KarpelesLab/scaffold/hw/rev2/DESIGN.md

# Scaffold Rev 2 — design specification

Status: **draft, in progress**. Nothing here has been built or tested yet.

Rev 2 keeps the Rev 1.1 board's function, form factor (195 x 150 mm), connectors
and register map, and changes three things:

1. Micro-USB is replaced by a USB-C receptacle.
2. The power tree is redesigned around USB Power Delivery (12 V request) with a
   wide-range external input, so the DUT and platform supplies can reach 5 V at
   1.5 A each.
3. The Intel Cyclone IV EP4CE22 (TQFP-144) is replaced by an AMD/Xilinx
   Artix-7 in the CSG324 package (XC7A35T, or XC7A100T on the same footprint).

The design moves from Altium to KiCad (`hw/kicad/`). The Altium files and the
Rev 1.1 fabrication outputs are kept unchanged for reference.

All part numbers are LCSC/JLCPCB codes, checked against JLCPCB's parts API on
2026-11-08. Stock changes daily: re-check before ordering (`hw/rev2/jlc_check.py`).

## 1. USB-C and power input

```
USB-C (J200) --VBUS--+-- CH224A (PD sink, requests 12 V) --> PG, I2C to FPGA
                     |
                     +--> TPS2121 IN2 ---+
CN202 terminal block (7-20 V) --> IN1 ---+--> VIN (5..20 V) --> S200 power switch
```

| Ref | Function | Part | LCSC | Notes |
|---|---|---|---|---|
| J200 | USB-C receptacle | GCT USB4105-GF-A | C3020560 | USB 2.0, 5 A, THT shell pegs for mechanical strength |
| U209 | USB-PD sink controller | WCH CH224A | C42459160 | ESSOP-10. 24 kΩ on CFG1 = 12 V request. Single-resistor mode also enables I²C (addr 0x22/0x23) |
| U210 | Input power mux | TI TPS2121RUXR | C485916 | 2.8–22 V, 4.5 A, priority to the external input |

Rules:

- **CH224A DP/DM pins are left unconnected.** They perform BC1.2/QC
  handshakes, which would corrupt the FT232RL USB data on D+/D-. PD is
  negotiated on CC only.
- VBUS and VHV are tied together (datasheet), 1 µF/50 V on VHV.
- CH224A CFG2/SCL and CFG3/SDA go to FPGA bank 15 (3.3 V) with 4.7 kΩ pull-ups
  to 3V3. The gateware can later read the PD contract (register 0x09 status,
  0x50 maximum current in 50 mA units) and request another voltage (0x0A).
  CH224A PG (open drain, active low) goes to the FPGA and to a "PD OK" LED.
- D+/D- go from J200 (A6/B6, A7/B7 paired) to the FT232RL through the existing
  ESD diodes, 90 Ω differential.
- With a plain 5 V source (no PD), the board still runs but the VPRE buck goes
  into dropout: DUT/platform supplies are then limited to about 4.2 V, as on
  Rev 1.1.

## 2. Power tree

```
VIN (5-20 V)
 |-- U211 TPS62933P  -> VPRE 6.0 V / 3 A ---+-- U200 TL1963A -> VCC_PLATFORM 1.2-5.0 V / 1.5 A
 |                                          +-- U202 TL1963A -> VCC_DUT      1.2-5.0 V / 1.5 A
 |                                          +-- U205 TL1963A -> VCC_IO_FPGA  1.2-3.3 V
 |                                          +-- U212 TL1963A -> Vsupply      5.0 V (FT232, level shifters, LED driver)
 |-- U213 TPS62933P  -> 1V0   (VCCINT, VCCBRAM) -- PG -+
 |-- U214 TPS62933P  -> 1V8   (VCCAUX, VCCADC)  <- EN -+ -- PG -+
 |-- U215 TPS62933P  -> 3V3_FPGA (VCCO 0/14/15, flash, osc) <- EN +
```

| Ref | Function | Part | LCSC |
|---|---|---|---|
| U211, U213–U215 | 3 A synchronous buck, 3.8–30 V in, with PG | TI TPS62933PDRLR | C5219254 |
| U200, U202, U205, U212 | 1.5 A low-noise adjustable LDO | TI TL1963ADCQR (unchanged from Rev 1.1) | C86720 |

- The DUT and platform supplies stay on low-noise LDOs. Switching regulators
  are never in the measured path, which matters for side-channel measurements
  through the shunt amplifier.
- VPRE = 6.0 V leaves 0.66 V headroom over the TL1963A 340 mV dropout at 1.5 A
  for a 5.0 V output. Worst-case LDO dissipation (1.2 V out, 1.5 A) is 7.2 W:
  more than an SOT-223 can sink. The PTC fuses (F202, F203) on the external
  platform/DUT supply inputs stay at 0.5 A as on Rev 1.1.
  **Open point:** add a thermal pad array or limit to 1 A at low output
  voltages; to be decided at layout.
- Artix-7 sequencing per DS181: VCCINT → VCCAUX → VCCO. The 1V0 buck starts
  first; its PG (pulled up to Vsupply 5 V, within the 5.5 V EN/PG limit)
  enables 1V8, whose PG enables 3V3_FPGA. VCC_IO_FPGA's TL1963A enable is
  driven by the 3V3 PG.
- TPS62933P switching frequency: 500 kHz (RT floating) on VPRE, 1.2 MHz on the
  FPGA rails (smaller inductors). Inductors and capacitors from the JLC basic
  library where possible; values set at schematic capture from the datasheet
  design equations.
- Power budget at 12 V / 3 A (36 W): DUT 7.5 W + platform 7.5 W + VCC_IO 2 W +
  FPGA (35T, worst case) ~2 W + logic 1 W ≈ 20 W input with conversion losses.

### As captured (hw/kicad/Power.kicad_sch, generated by hw/rev2/tools/gen_power.py)

| Rail | Regulator | Divider (top/bottom) | Nominal | Inductor (LCSC) |
|---|---|---|---|---|
| VPRE | U211 TPS62933P, 500 kHz | 30k / 4.7k | 5.91 V | 10 µH CJiang FXL1040-100-M (C475915), 7.8 A |
| 1V0 | U213 TPS62933P | 2.4k / 10k | 0.99 V | 3.3 µH FNR6045S3R3NT (C168063) |
| 1V8 | U214 TPS62933P | 15k / 12k | 1.80 V | 4.7 µH FNR6045S4R7MT (C168067) |
| 3V3_FPGA | U215 TPS62933P | 47k / 15k | 3.31 V | 10 µH FNR6045S100MT (C168076) |
| Vsupply | U212 TL1963A (from VPRE) | 47k / 15k | 5.00 V | — |

- Only JLC basic resistors and capacitors are used in the new power section.
- TPS2121: PR1 51k/10k (VEXT priority above 6.5 V), OV1/OV2 200k/10k (cut-off
  above 22 V on either input), ILM 22k (about 4.5 A), SS 10 nF, ST tied to GND.
- SMAJ20A TVS on VBUS_C (D207) and VEXT (D210).
- USB-PD status: D208 (red, basic part) lights when the CH224A reports the 12 V
  contract (PG low). PD_SCL/PD_SDA are global labels to the FPGA sheet, with
  10k pull-ups to 3V3_FPGA.
- **FT232RL USB detection**: Rev 1.1 divided VBus directly into RESET#
  (4.75k/10k), which would put 8 V on RESET# at 12 V. Rev 2 adds R222 4.7k +
  D209 4.7 V zener (VBUS_SENSE), and R603 becomes 1k: RESET# is about 3.2 V
  with 5 V VBUS and stays below 4.4 V at 20 V.
- Removed from Rev 1.1: J200 micro-B, F200/F201, L200, CN203 (source select
  jumper, replaced by the TPS2121), D202 (6 V ESD diode on VBus, replaced by
  the TVS), U204/U206/U207/U208 and their capacitors (old FPGA/LED rails).
- The new footprint for the FXL1040 inductor is in `hw/kicad/Scaffold_Rev2.pretty`
  (land pattern from the CJiang datasheet).
- **To check against the TI drawing before ordering**: the KiCad
  `Texas_VQFN-HR-12_2x2.5mm` footprint used for the TPS2121 (RUX0012A).

## 3. FPGA

| Ref | Function | Part | LCSC |
|---|---|---|---|
| U100 | FPGA | XC7A35T-1CSG324I (default) / XC7A100T-1CSG324C (same footprint) | C1521726 / C1521768 |
| U105 | Configuration flash, 128 Mbit quad SPI | Winbond W25Q128JVSIQ (JLC basic part) | C97521 |
| P100 | JTAG | 2x7 2.0 mm Xilinx header, or 6-pin 2.54 mm (Digilent HS2 pinout) | — |
| Y100 | 25 MHz oscillator | unchanged | — |

- Configuration mode: Master SPI x4 (M[2:0] = 001), CFGBVS = VCCO (bank 0 at 3.3 V).
- The 25 MHz oscillator goes to an MRCC pin in bank 14 or 15. The MMCM
  generates the 100 MHz system clock (VCO 1000 MHz).
- Banks 14 and 15 are on 3V3_FPGA (UART, LED driver, PD controller, flash,
  power enables). Banks 34 and 35 (HR banks) are on the adjustable
  VCC_IO_FPGA and carry the DUT/platform I/Os (A0–A3, D0–D15, P0–P15).
- The design needs about 60 pins out of 210, so only the two outer ball rows
  need breaking out. Unused balls stay unconnected.
- Programming: JTAG through Vivado, or `openFPGALoader`, which also programs
  the W25Q128 flash. The Vivado flash programmer does not list every
  Winbond part, so check before relying on it.

Gateware: `fpga-arch/artix7/` (Vivado build script `build.tcl`, constraints
`scaffold.xdc`). The vendor-specific Rev 1.x modules are replaced by
vendor-neutral ones; the Rev 1.x Quartus project is unchanged.

### As captured (hw/kicad/FPGA.kicad_sch, generated by hw/rev2/tools/gen_fpga.py)

- Pin assignment: `hw/rev2/fpga_pins.csv` (71 nets). Generated automatically:
  outermost balls first in each bank, clocks on MRCC pins, configuration
  pins of bank 14 reserved. Banks 35 (IO0-15_DUT, D0-D2 pulls) and 34
  (IO0-15_PLAT) on VCC_IO_FPGA; bank 15 (clocks, reset, LED driver, A0-A3,
  DIR, TEARING, power enables) and bank 14 (UART, PD I2C, 7 spare I/Os to
  TP102-TP108) on 3V3_FPGA. `fpga-arch/artix7/scaffold.xdc` pins are generated
  from it by `hw/rev2/tools/gen_xdc.py`.
- Configuration: W25Q128JVSIQ (U105) on CCLK/D00-D03/FCS_B; 10k pull-ups on
  FCS_B, IO2 (/WP), IO3 (/HOLD); PROGRAM_B and INIT_B 4.7k pull-ups; DONE
  330 Ω pull-up; M0 1k to 3V3, M1/M2 1k to GND; PUDC_B 1k to 3V3 (I/O
  pull-ups off during configuration; LED_/OE, the power enables and the
  level shifter DIR lines all have external pulls). CFGBVS to 3V3.
- JTAG: 1x6 0.1" header P100 with the Digilent JTAG-HS2/HS3 pinout
  (1 VDD, 2 GND, 3 TCK, 4 TDO, 5 TDI, 6 TMS); also usable with
  openFPGALoader and FT2232H-based cables.
- Unused special pins: VP/VN, VREFP/VREFN (internal XADC reference),
  DXP/DXN, VCCBATT tied to GND. VCCADC from 1V8 through a ferrite bead
  (L100), 1 µF + 100 nF.
- Decoupling per UG483 v1.13 Table 2-2, sized for the XC7A100T so both
  devices can be fitted: 1V0 2x100 µF + 6x4.7 µF + 10x0.47 µF, 1V8
  47 µF + 2x4.7 µF + 4x0.47 µF, 3V3 banks 2x47 µF + 5x4.7 µF + 10x0.47 µF,
  VCC_IO banks 47 µF + 4x4.7 µF + 8x0.47 µF (all JLC basic parts). The
  330 µF VCCINT bulk of the XC7A100T is replaced by ceramics.

## 4. Other changes forced by availability

- **LED driver** (decided, captured in `hw/kicad/LEDs.kicad_sch`, generated by
  `hw/rev2/tools/gen_leds.py`): the TLC5952DAP is out of stock at JLCPCB.
  It is replaced by 3 x 74HC595D (Nexperia 74HC595D,118, LCSC C5947, JLC basic
  part) U400–U402 on 3V3_FPGA. LED anodes move from Vsupply (5 V) to
  3V3_FPGA and each cathode goes through a resistor to a 74HC595 output
  (active low): 680 Ω (~1.8 mA) for the single LEDs, 330 Ω for the bicolour
  D400/D401. The Rev 1.1 channel of every LED is kept (bit k drives the LED
  that was on TLC5952 output k). U400 QA..QH = LED0..7, U401 = LED8..15,
  U402 = LED16..23; QH' of U402 returns to the FPGA as LED_SDO. R425 (10k
  pull-up on LED_/OE) keeps the LEDs off until the FPGA is configured.
  Gateware: `fpga-arch/artix7/tlc5952_driver.vhd` keeps the entity name and
  ports (so `leds_module` is unchanged), shifts the inverted LED bits, and
  turns the brightness into a ~10 kHz PWM on /OE with duty
  (brightness + 1)/128. Tested in `fpga-sim/artix7/tb_leds.vhd`.
- **EPCS16** (Intel-only configuration device) → W25Q128JVSIQ, see above.
- **ADA4895-1ARJZ** (current measurement amplifier) is in low stock (33 pcs,
  ~$10). Keep, re-check before ordering.

## 5. PCB

- Stackup (decided): **6 layers**, JLC 1.6 mm.
  Layers: L1 signal, L2 GND, L3 signal, L4 power, L5 GND, L6 signal.
  The under-BGA decoupling capacitors sit on their vias (via-in-pad): order
  with JLC's epoxy-filled, capped vias (POFV) option. The
  CSG324 is a 0.8 mm-pitch BGA; 6 layers keep two solid ground planes,
  including the one under the analog measurement path.
- BGA fanout: 0.2 mm drill / 0.4 mm via, 0.1 mm tracks under the BGA
  (JLC multilayer minimum: 0.09 mm track/space, 0.15 mm drill).
- Board outline, mounting holes, connector, LED and SMA positions unchanged.

### Layout as implemented (scripted, see `hw/rev2/tools/layout.sh`)

Pipeline: `layout_rules.py` (rules, net classes) -> `update_pcb.py` (sync
with the schematic) -> `place.py` (placement, bucks from the `buck.py`
template) -> `fanout.py` (BGA fanout, decoupling, planes) -> `stitch.py`
(plane vias, buck power copper) -> `manual_routes.py` (J501-J502 bus) ->
routing. `layout.sh` runs these steps; routing was then done as follows,
and the board file is the reference (the routing steps are not a one-shot
script):

1. Freerouting, incremental (`route.py export` locks existing copper and
   prunes dangling stubs; `route.py import`; `postroute.py` fixes minimum
   widths and slivers). Five passes took the board from ~500 to 43
   unconnected; each pass is ~1.5 h and gains less.
2. `maze.py`, a grid A* router written for the rest (numpy/scipy, runs
   outside KiCad): `maze_export.py` -> `maze.py` -> `maze_apply.py`.
   0.05 mm grid aligned on the BGA pitch, top/Signal/bottom layers, net
   class clearances checked with a grid margin (`MAZE_TIGHT` for fine-pitch
   escapes, every result verified with KiCad's DRC), connectivity through
   planes, per-net width/via/neck overrides and flags (outer layers only,
   extra vias, no vias). `ripup.py` clears a box or whole nets when a pad
   is boxed in; boxed-in areas were re-routed with the stuck net first.
3. The 3 A input stage (VBUS_C, VEXT, VIN_MUX: 0.8 mm on the outer 1 oz
   layers, extra vias at each layer change, 0.35 mm necks at the TPS2121
   pins) and the DUT/platform supplies (VCC_DUT, VCC_PLATFORM and the
   PERMANENT nets: 1.5 mm, outer layers) were ripped up and re-routed wide.

4. Post-route copper (review of 2026-11-09, section 8): `thermal.py`
   (vias in the LDO ground tabs and in the SMA ground legs, group
   `rev2_thermal`) and `widen.py` (power tracks widened where they clear,
   extra vias and parallel links, group `rev2_power`).

Result: 0 unconnected pads, no clearance, short or track-width errors.

- Stackup: Top (signal) / GND1 (plane) / Signal / Power (split plane) /
  GND2 (plane) / Bottom (signal). The board file carries JLC's
  JLC06161H-2116 build (1.6 mm): 35 um outer / 15.2 um inner copper;
  dielectrics 0.2234 mm (2116+2313, er 4.1), 0.3 mm core (4.6), 0.4168 mm
  (2 x 7628, 4.4), 0.3 mm core, 0.2234 mm. Select this stackup when
  ordering if impedance matters (see section 8).
- Rules: 0.1 mm track/clearance for the BGA nets (classes FPGA_IO,
  FPGA_PWR, GND), 0.2 mm default, 0.8 mm power tracks; vias 0.4/0.2 mm at the
  BGA, 0.6/0.3 mm elsewhere. kicad-cli ignores `.kicad_dru` custom rules,
  so every constraint is expressed through net classes.
- Placement: everything kept from Rev 1.1 is untouched (connectors,
  headers J500-J503 for daughter board compatibility, SMA, LEDs, DIP
  switches, holes). USB-C at the old micro-USB position; PD controller and
  input mux below it; VPRE/1V8/3V3 bucks in the former logo area; the 1V0
  buck next to the BGA (short high-current path). Each TPS62933P follows one
  template: input caps on VIN/GND (pins 3/4), bootstrap cap on BST/SW (pins
  6/5), inductor next to SW, output caps against the inductor, FB divider
  above the IC; input loop, bootstrap and output tracks are drawn by script
  and the switch node is a small top-layer zone (pin 5, Cbst, inductor). BGA rotated 180 degrees so
  banks 34/35 (DUT/platform I/Os) face the J500-J503 headers.
- Fanout: dog-bone vias for every power/ground ball and every signal ball
  from the third ring inwards; the two outer rings escape on the top layer.
- Decoupling: 0402 capacitors on supply/ground via pairs under the BGA, the
  others in a ring around it on the side of their plane region; bulk
  capacitors beyond the ring.
- Power plane (In3): 1V0 island under the core with a corridor through
  unused ball rows to its buck; 1V8 strip from the VCCAUX column; 3V3 (left,
  bottom, LED rows) and VCC_IO (banks 34/35 side) split under the BGA by
  nearest VCCO ball; VIN in the power input area; VPRE from its buck to the
  LDO inputs. The buck inputs get 12 V from a VIN zone on the Signal layer
  (In2), which has nothing else to carry in the power area.
- Known DRC items accepted (95 errors, all footprints): Rev 1.1 edge-mount
  SMA connectors CN100/CN2xx/CN3xx (copper at the board edge by design,
  internal hole and mask clearances), GCT USB4105 land pattern J200
  (0.194 mm hole clearance vs 0.2 mm rule); warnings: terminal block
  padstacks, silkscreen sizes and library mismatches of the footprints
  imported from Altium, U100 no-connect net names (unit suffix) and empty
  Description fields in the schematic parity check.
- Placement changes made while routing: C224 (mux output cap) above-right
  of U210, so the 3 A output does not cross the inputs; LED resistors
  R409-R424 in two rows at 4 mm pitch (2 mm left no room to route).

## 6. JLCPCB outputs

Generated by `hw/rev2/make_jlc.py` (KiCad Python) into `hw/rev2/jlc/`:

- `scaffold-rev2-gerbers.zip`: 6 copper layers, mask, paste, silkscreen,
  outline and Excellon drill files (absolute origin for both)
- `bom-jlc.csv`: Comment, Designator, Footprint, LCSC
- `cpl-jlc.csv`: Designator, Mid X, Mid Y, Layer, Rotation (pad centres)
- `hand-assembly.csv`: parts JLCPCB does not stock (Samtec SMA, headers,
  terminal blocks, switches, Mill-Max pins), to fit by hand
- `drc.txt`, `report.txt`

LCSC numbers come from the footprint `LCSC` field or, for parts carried over
from Rev 1.1, from `hw/rev2/lcsc_map.csv` by manufacturer part number
(`assembly` column: `jlc` or `hand`). Check rotations in JLCPCB's placement
preview: footprints imported from Altium may need a correction.

## 7. Pre-order review checklist

Points that need a human check (datasheet or tool not available here):

1. TPS2121 footprint (KiCad `Texas_VQFN-HR-12_2x2.5mm_P0.5mm`) against TI's
   RUX0012A land pattern.
2. Digilent 6-pin JTAG pinout (taken from the JTAG-HS2 reference manual figure).
3. Tie-off of DXP/DXN and VCCBATT to GND (secondary sources agree; UG480 /
   UG470 not checked directly).
4. VCCINT bulk: ceramic 2 x 100 µF instead of the 330 µF in UG483 for the
   XC7A100T. Check stability with the TPS62933 (ceramic-compensated) if the
   XC7A100T is fitted.
5. Platform/DUT LDO dissipation at low output voltage and high current (see
   section 2).
6. W25Q128JV quad mode: the QE bit must be set when programming the flash
   (openFPGALoader does it); Vivado's flash programmer may not support this
   part.
7. Vivado synthesis and timing of `fpga-arch/artix7` (no Vivado on the machine
   used for the port: only simulated/elaborated with nvc).
8. Layout review by a person before ordering: the board was placed and
   routed by scripts. In particular the buck switching loops (template in
   `buck.py`), the TPS2121 area (0.35 mm necks into its 0.5 mm-pitch pins),
   the analog path (ADA4895 area, kept from Rev 1.1 placement) and the
   routing near the BGA. The routes are electrically complete and pass DRC;
   they are not as tidy as hand routing (grid steps, some long detours).
9. Order options: 6 layers, 1 oz outer / 0.5 oz inner, via-in-pad plated
   over (POFV) for the 0402 decoupling capacitors under the BGA, minimum
   via 0.4/0.2 mm, minimum track/space 0.1 mm. Inner layer order in the
   Gerbers: GND1 (.g1), Signal (.g2), Power (.g3), GND2 (.g4).
10. Outer ground pours: areas enclosed by tracks without a ground via are
    removed as islands (between the header rows); the two inner ground
    planes are solid. Optional: add ground vias there to keep the pour.
11. Low JLCPCB stock at the time of generation (2026-11-09): ADA4895-1 (33),
    25 MHz oscillator ECS-2520S33-250 (49), XC7A35T (227). Re-check with
    `hw/rev2/jlc_check.py --bom hw/rev2/jlc/bom-jlc.csv --qty N`.
12. VEXT (external input) passes through one 0.4 mm via at (79.0, 53.5)
    next to R225: fine at 12 V (about 2 A), marginal at the 4 A worst
    case (7 V input, full load). No room for a second via on the top
    layer there without moving R223/R225.

## 8. Layout review and simulation (2026-11-09)

Tools in `hw/rev2/sim/` (`run.sh` runs everything; results in
`hw/rev2/sim/results/`):

- `export_copper.py` (KiCad Python): copper of chosen nets, or of every net
  in a box, as polygons per layer with vias, holes and pads.
- `irdrop.py`: DC drop and current density of each power net (resistor
  network on a 0.05/0.1 mm raster, via barrels, worst-case load currents).
- `em_sim.py`: openEMS FDTD model of a box of the real copper (stackup
  above, PEC copper, vias as cylinders, lumped ports, PML). openEMS is
  built from source (`openEMS-Project`, `update_openEMS.sh --python`, needs
  `brew install hdf5 cgal boost`) into `~/opt/openEMS`; its Metal GPU
  engine runs these models about 50x faster than the CPU engine.
  Modelling rules learned the hard way: the copper must run into the PML
  (a track ending at the absorber is an open stub) and vias must stay out
  of it (vertical conductors in the PML make the run unstable).

Findings and changes:

| Check | Result | Action |
|---|---|---|
| DC drop, all power nets, worst case | Largest: VEXT 4 A 123 mV (was 151), VIN_MUX 55 mV, VCC_DUT 57 mV and VCC_PLATFORM 47 mV at 1.5 A, 1V0 24 mV at 2 A, 1V8 24 mV, VCC_IO 7 mV, 3V3 2 mV | VEXT/VIN_MUX/VBUS widened to 1-2 mm where they clear, parallel VEXT links beside the TPS2121 (`widen.py`) |
| Current density | Hot spots only at the TPS2121 pin necks (package-limited) and pad entries; VBUS trunk 0.8 mm beside the mounting hole (3 A, ~20 C rise per IPC-2152) | Noted |
| Return paths | No signal segment runs more than 1.5 mm without its reference plane below (crossings are via antipads under the BGA) | None |
| SMA connectors (13) | Ground legs had no via: the shield current reached the planes only through the top pour | 7 vias in each ground leg (`thermal.py`). CN205 shunt output: S21 at 1 GHz -1.01 -> -0.82 dB, at 2 GHz -3.69 -> -3.37 dB; the rest is the THP200 test-pin hole in the path (as Rev 1.1) |
| LDO tabs (TL1963A) | No via under the ground tab | 0.3 mm via grid in the tabs of U200 (4), U202 (6), U205 (6); U212 has In2 tracks under it (0.2 W, not needed) |
| CLK_EXT (CN100 -> G16) | 0.1 mm top trace, Z0 about 61-75 ohm (port at the SMA pin, line into the absorber); clean via transition into the BGA (port mid-line sees ~33 ohm = Z0/2, flat to 2 GHz) | None: 42 mm at clock edges of ~1 ns, reflection coefficient ~0.15 against a 50 ohm source |
| Buck input loop (U211, VIN -> C226 -> GND) | 1.0 nH including the port gap (0.94-1.03 nH, 100-500 MHz) | None (good for this package; C226 is 1.5 mm from the pins) |
| Stackup in the board file | Was the 4-layer Altium one (no In3/In4, 1.45 mm) | Replaced with JLC06161H-2116 |
| FPGA decoupling | 0.47 uF 1V0 caps 0.4-0.9 mm from their balls (under the BGA); 1V8 caps 7.6-9 mm and 1V0 4.7 uF 6.6-8.4 mm away, fed by the In3 islands | Acceptable at plane level; no PDN impedance simulation was run |
