KarpelesLab/scaffold/hw/rev2/jlc/bom-jlc.csv

Comment | Designator | Footprint | LCSC
100uF 6.3V | C100,C101 | C_1206_3216Metric | C15008
4.7uF 10V | C102,C103,C104,C105,C106,C107,C119,C120,C127,C128,C129,C130,C131,C158,C159,C160,C161 | C_0402_1005Metric | C23733
470nF 10V | C108,C109,C110,C111,C112,C113,C114,C115,C116,C117,C121,C122,C123,C124,C132,C133,C134,C135,C143,C144,C145,C146,C155,C156,C162,C163,C164,C165,C166,C167,C168,C169 | C_0402_1005Metric | C47339
47uF 6.3V | C118,C125,C126,C157 | C_0805_2012Metric | C16780
100nF | C136,C151,C153,C154,C205,C600,C601,C602,C603,C605,C606,C607,C608,C609,C610,C611 | CAP0603 | C14663
10uF | C137,C200,C201,C202,C204,C208,C209,C210,C217,C218 | CAP0603 | C86277
1uF 50V | C170,C221,C222 | C_0603_1608Metric | C15849
100nF 50V | C171,C226,C227,C232,C233,C238,C239,C243,C244,C400,C401,C402 | C_0603_1608Metric | C14663
1uF | C206,C207 | CAP0603 | C15849
10nF 50V | C223 | C_0603_1608Metric | C57112
10uF 50V | C224,C225,C231,C237,C242 | C_1206_3216Metric | C13585
22uF 25V | C228,C229,C230,C234,C235,C236,C240,C241,C245,C246 | C_0805_2012Metric | C45783
10uF 25V | C247,C248 | C_0805_2012Metric | C15850
4.7uF | C604 | CAP0603 | C19666
Male | CN207 | MOLEX_90120-0122 | C3336192
BAT60J | D200,D201,D205,D206 | SOD323_A | C133103
ESDAXLC6-1BT2 | D203,D204 | SOD882 | C154523
SMAJ20A | D207,D210 | D_SMA | C115250
PD 12V OK (red) | D208 | LED_0603_1608Metric | C2286
BZT52C4V7 | D209 | D_SOD-123 | C2116
LED RG | D400,D401 | PLCC-4_3528 | C5872444
KT-0603Y | D402,D403,D404,D405,D406,D407,D408,D409,D410,D411,D412,D416,D417,D418,D419,D420,D421,D422,D423 | LED_0603_1608Metric | C2287
KT-0603R | D415 | LED_0603_1608Metric | C2286
PTC - 1A - 0.5A - 6VDC | F202,F203 | FUSE_0805 | C5220829
USB4105-GF-A | J200 | USB_C_Receptacle_GCT_USB4105-xx-A_16P_TopMnt_Horizontal | C3020560
600R@100MHz | L100 | L_0603_1608Metric | C1002
10uH | L201 | L_CJiang_FXL1040 | C475915
3.3uH | L202 | L_Changjiang_FNR6045S | C168063
4.7uH | L203 | L_Changjiang_FNR6045S | C168067
10uH | L204 | L_Changjiang_FNR6045S | C168076
JTAG | P100 | PinHeader_1x06_P2.54mm_Vertical | C492405
STR2P3LLH6 - SOT23 | Q200,Q203 | SOT23 | C3040112
STT6N3LLH6 - SOT23-6 | Q201,Q202,Q204,Q205 | SOT95P280X145-6N | C3021100
47KOhm | R100 | RES0603 | C25819
10k | R101,R102,R103,R220,R221,R224,R226,R228,R233,R425 | R_0603_1608Metric | C25804
4.7k | R104,R105,R222,R231 | R_0603_1608Metric | C23162
330 | R106,R419,R420,R423,R424 | R_0603_1608Metric | C23138
1k | R107,R108,R109,R113 | R_0603_1608Metric | C21190
10KOhm | R110,R111,R112,R301,R305,R307,R309,R313,R317,R319,R321,R323,R327,R331,R333,R335,R338,R339,R341,R343,R347,R348,R349,R351,R600,R601,R602,R604,R605 | RES0603 | C25804
50 kOhms | R200,R207,R216 | POT_3296W | C83686
470Ohm | R201,R209 | RES0603 | C23179
15KOhm | R202,R211 | RES0603 | C22809
2Ohm | R203,R204,R212,R213 | RES0603 | C22977
1K | R205,R214,R215,R304,R306,R308,R312,R316,R318,R320,R322,R326,R330,R332,R334,R340,R342,R346,R350 | RES0603 | C21190
50 Ohm | R206 | RES0603 | C23185
100Ohm | R208 | RES0603 | C22775
100 Ohms | R210 | POT_3296W | C83688
28KOhm | R217 | RES0603 | C22989
24k | R218 | R_0603_1608Metric | C23352
2.2k | R219 | R_0603_1608Metric | C4190
51k | R223 | R_0603_1608Metric | C23196
200k | R225,R227 | R_0603_1608Metric | C25811
22k | R229 | R_0603_1608Metric | C31850
30k | R230 | R_0603_1608Metric | C22984
2.4k | R232 | R_0603_1608Metric | C22940
15k | R234,R237,R239 | R_0603_1608Metric | C22809
12k | R235 | R_0603_1608Metric | C22790
47k | R236,R238 | R_0603_1608Metric | C25819
100k | R240 | R_0603_1608Metric | C25803
0 Ohm | R300,R302,R303,R310,R311,R314,R315,R336,R337,R344,R345 | RES0603 | C21189
680 | R401,R402,R403,R404,R405,R406,R407,R408,R409,R410,R411,R412,R413,R414,R415,R416,R417,R418,R421,R422 | R_0603_1608Metric | C23228
1 KOhm | R603 | RES0603 | C21190
Misc - DIP switch - 8 rows - TE connectivity - 1825057-7 -ADE0804 | S300,S301,S302,S303 | SWDIP16_300X3.51 | C266199
XC7A35T-1CSG324I | U100 | Xilinx_CSG324 | C1521726
W25Q128JVSIQ | U105 | SOIC-8_5.3x5.3mm_P1.27mm | C97521
TL1963A | U200,U202,U205,U212 | SOT223-6 | C86720
LDK130_33 | U201 | SOT95P280X145-5L30 | C2969807
ADA4895-1 | U203 | SOT95P280X145-6N | C654294
CH224A | U209 | SSOP-10-1EP_3.9x4.9mm_P1mm_EP2.1x3.3mm | C42459160
TPS2121RUXR | U210 | Texas_VQFN-HR-12_2x2.5mm_P0.5mm | C485916
TPS62933PDRLR | U211,U213,U214,U215 | SOT-583-8 | C5219254
74HC595D | U400,U401,U402 | SOIC-16_3.9x9.9mm_P1.27mm | C5947
SN74LVC1T45DBVR | U600,U601,U602,U604 | SOT95P280X145-6N | C7843
IC - USB-to-UART 1-CH 256Byte FIFO - 5V - 28-Pin SSOP | U603 | SSOP28DB | C8690
Oscillator - 25MHz - 3.3V - HCMOS - ECS-2520S33-250-FN-TR | Y100 | XTAL_2520 | C2441341
