KarpelesLab/scaffold/hw/kicad/Scaffold.kicad_pcb

## KiCad design hw/kicad/Scaffold.kicad_pcb (2026-11-09)

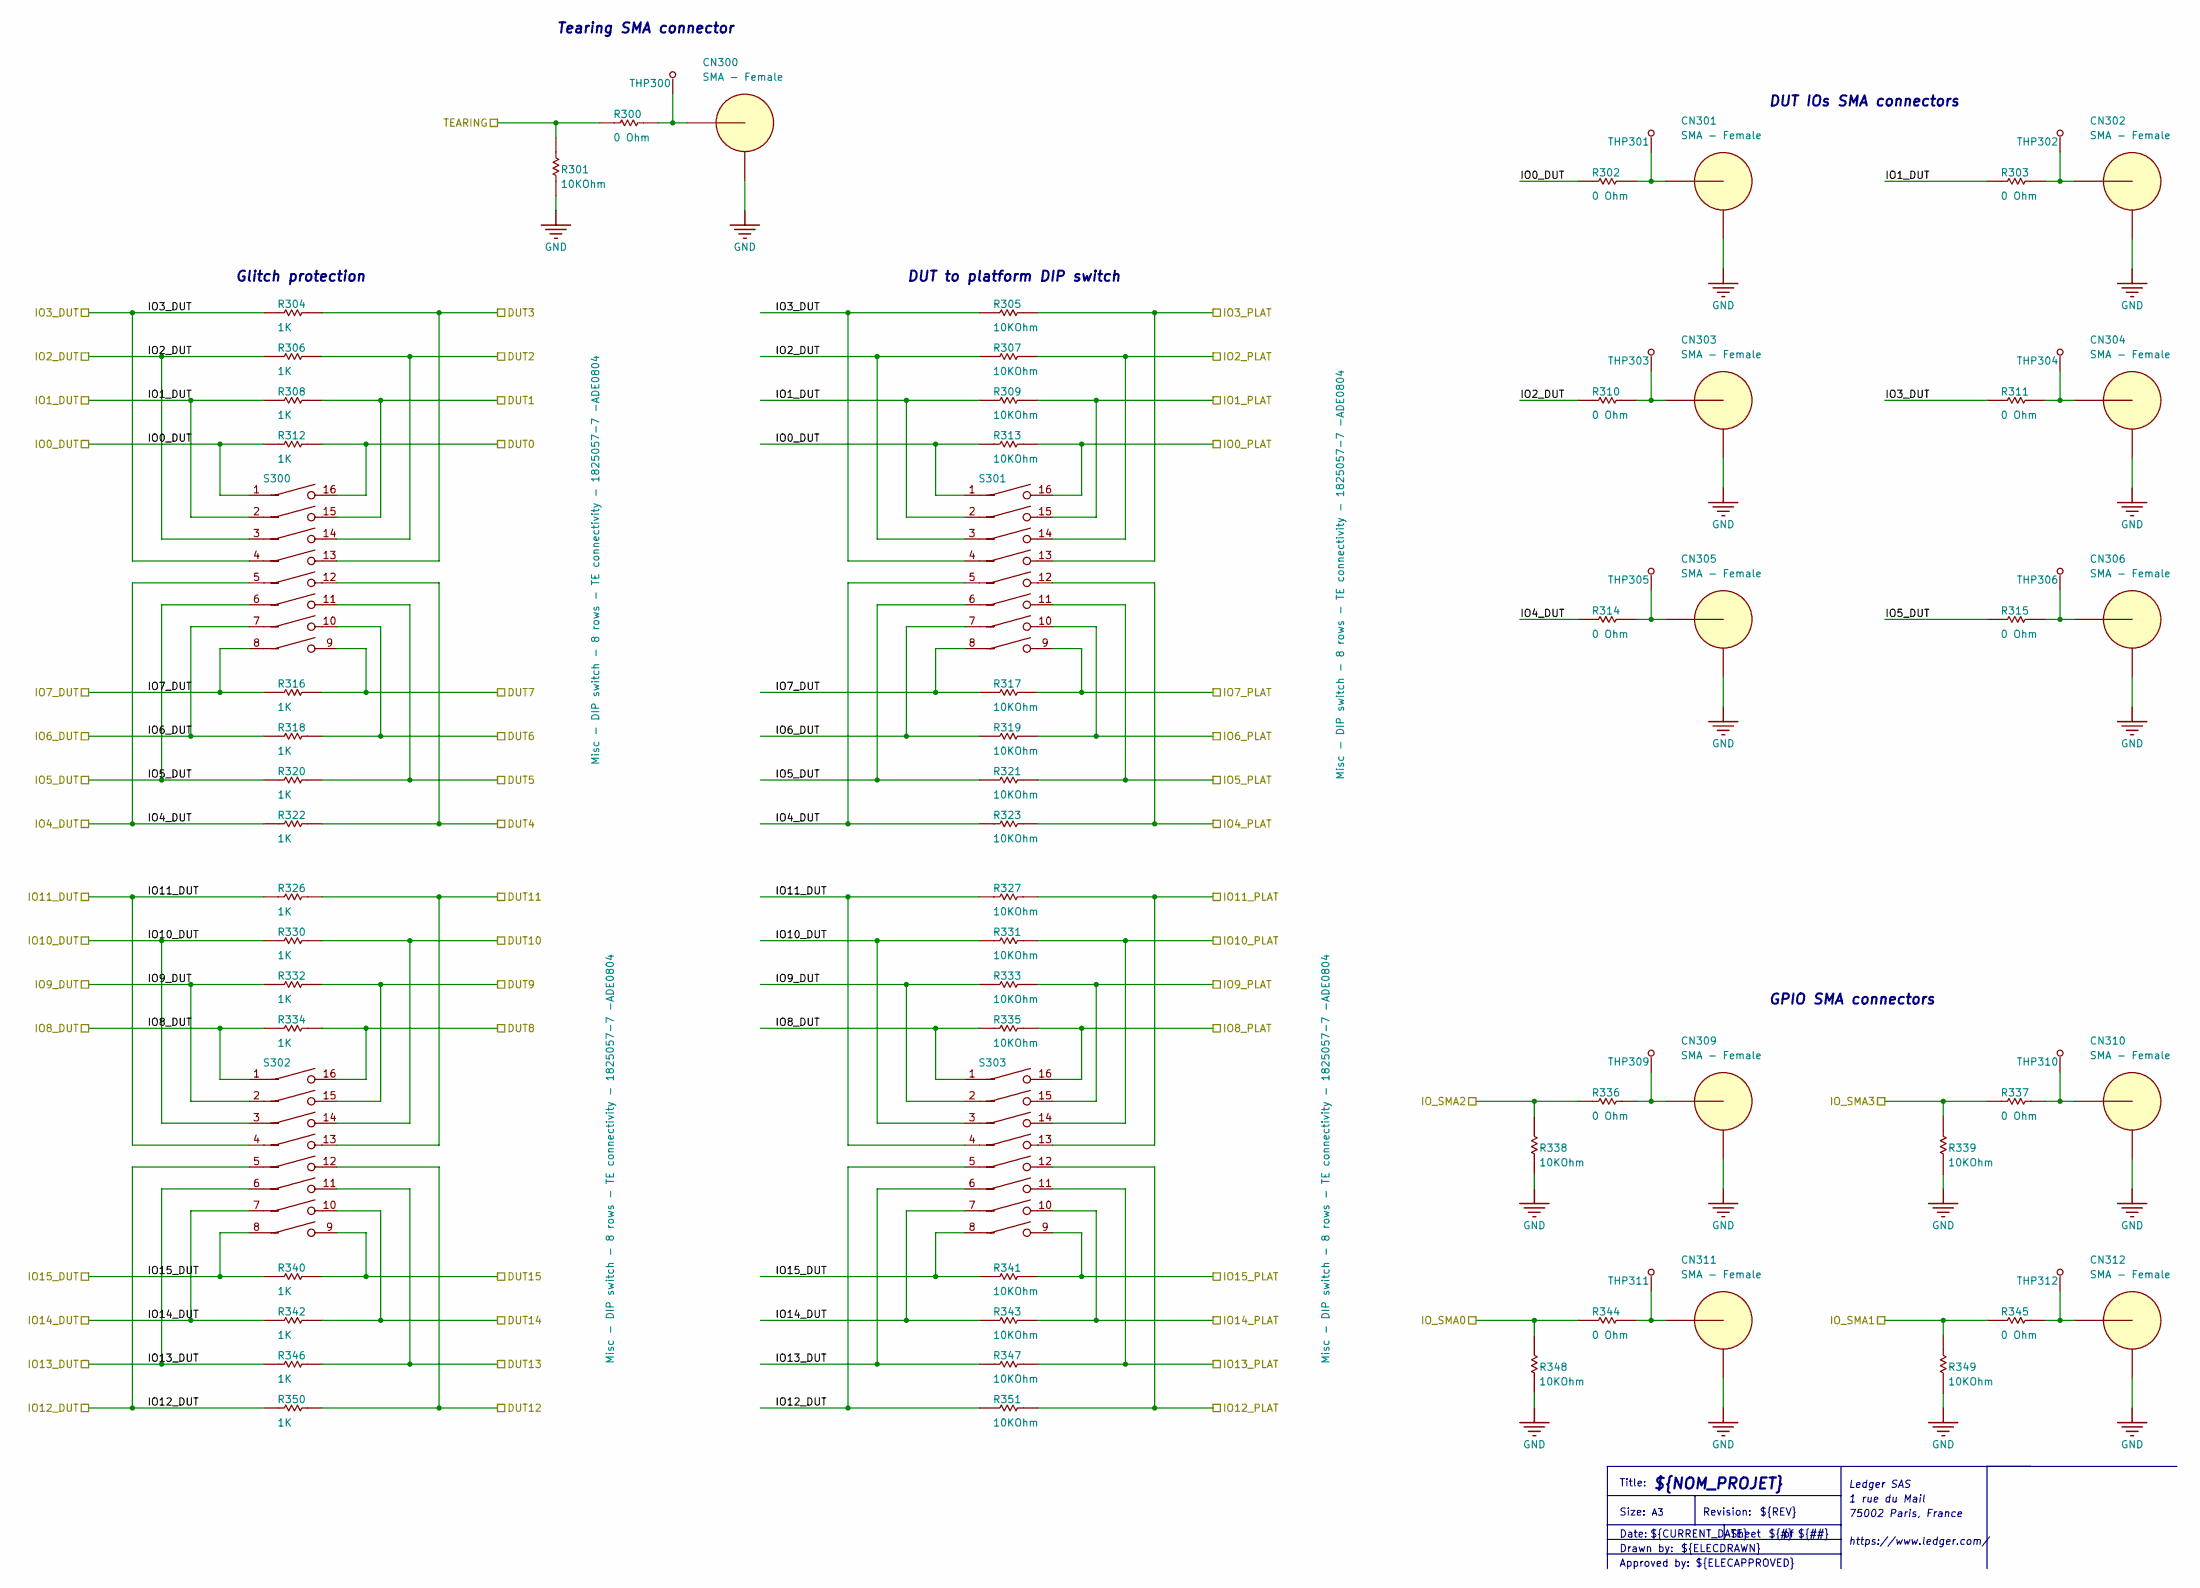
[picture p1: schematic Connectors.kicad_sch]

Parts:
CN300, CN301, CN302, CN303, CN304, CN305, CN306, CN309, CN310, CN311, CN312: SMA - Female; SAMTEC_SMA-J-P-X-ST-EM3; MANUFACTURER PN SMA–J–P–H–ST–EM3
R300, R302, R303, R310, R311, R314, R315, R336, R337, R344, R345: 0 Ohm; RES0603; TOLERANCE 1%; MANUFACTURER PN CRCW06030000FKEA
R301, R305, R307, R309, R313, R317, R319, R321, R323, R327, R331, R333, R335, R338, R339, R341, R343, R347, R348, R349, R351: 10KOhm; RES0603; TOLERANCE 1%; MANUFACTURER PN RC0603FR-0710KL
R304, R306, R308, R312, R316, R318, R320, R322, R326, R330, R332, R334, R340, R342, R346, R350: 1K; RES0603; TOLERANCE 1%; MANUFACTURER PN RC0603FR-071KL
S300, S301, S302, S303: Misc - DIP switch - 8 rows - TE connectivity - 18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; SWDIP16_300X3.51; MANUFACTURER PN1 ADE0804
THP300, THP301, THP302, THP303, THP304, THP305, THP306, THP309, THP310, THP311, THP312: Misc - Test pin - Through hole - Millmax - 6821-0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; MILLMAX_6821-0-00-15-00-00-08-0; MANUFACTURER PN 6821-0-00-15-00-00-08-0

Connections:
/DUT_D0: R312.2, S300.16; also elsewhere on the board
/DUT_D1: R308.2, S300.15; also elsewhere on the board
/DUT_D2: R306.2, S300.14; also elsewhere on the board
/U_Connectors/DUT3: R304.2, S300.13; also elsewhere on the board
/U_Connectors/DUT4: R322.2, S300.12; also elsewhere on the board
/U_Connectors/DUT5: R320.2, S300.11; also elsewhere on the board
/U_Connectors/DUT6: R318.2, S300.10; also elsewhere on the board
/U_Connectors/DUT7: R316.2, S300.9; also elsewhere on the board
/U_Connectors/DUT8: R334.2, S302.16; also elsewhere on the board
/U_Connectors/DUT9: R332.2, S302.15; also elsewhere on the board
/U_Connectors/DUT10: R330.2, S302.14; also elsewhere on the board
/U_Connectors/DUT11: R326.2, S302.13; also elsewhere on the board
/U_Connectors/DUT12: R350.2, S302.12; also elsewhere on the board
/U_Connectors/DUT13: R346.2, S302.11; also elsewhere on the board
/U_Connectors/DUT14: R342.2, S302.10; also elsewhere on the board
/U_Connectors/DUT15: R340.2, S302.9; also elsewhere on the board
/U_Connectors/IO0_DUT: R302.1, R312.1, R313.1, S300.1, S301.1; also elsewhere on the board
/U_Connectors/IO0_PLAT: R313.2, S301.16; also elsewhere on the board
/U_Connectors/IO1_DUT: R303.1, R308.1, R309.1, S300.2, S301.2; also elsewhere on the board
/U_Connectors/IO1_PLAT: R309.2, S301.15; also elsewhere on the board
/U_Connectors/IO2_DUT: R306.1, R307.1, R310.1, S300.3, S301.3; also elsewhere on the board
/U_Connectors/IO2_PLAT: R307.2, S301.14; also elsewhere on the board
/U_Connectors/IO3_DUT: R304.1, R305.1, R311.1, S300.4, S301.4; also elsewhere on the board
/U_Connectors/IO3_PLAT: R305.2, S301.13; also elsewhere on the board
/U_Connectors/IO4_DUT: R314.1, R322.1, R323.1, S300.5, S301.5; also elsewhere on the board
/U_Connectors/IO4_PLAT: R323.2, S301.12; also elsewhere on the board
/U_Connectors/IO5_DUT: R315.1, R320.1, R321.1, S300.6, S301.6; also elsewhere on the board
/U_Connectors/IO5_PLAT: R321.2, S301.11; also elsewhere on the board
/U_Connectors/IO6_DUT: R318.1, R319.1, S300.7, S301.7; also elsewhere on the board
/U_Connectors/IO6_PLAT: R319.2, S301.10; also elsewhere on the board
/U_Connectors/IO7_DUT: R316.1, R317.1, S300.8, S301.8; also elsewhere on the board
/U_Connectors/IO7_PLAT: R317.2, S301.9; also elsewhere on the board
/U_Connectors/IO8_DUT: R334.1, R335.1, S302.1, S303.1; also elsewhere on the board
/U_Connectors/IO8_PLAT: R335.2, S303.16; also elsewhere on the board
/U_Connectors/IO9_DUT: R332.1, R333.1, S302.2, S303.2; also elsewhere on the board
/U_Connectors/IO9_PLAT: R333.2, S303.15; also elsewhere on the board
/U_Connectors/IO10_DUT: R330.1, R331.1, S302.3, S303.3; also elsewhere on the board
/U_Connectors/IO10_PLAT: R331.2, S303.14; also elsewhere on the board
/U_Connectors/IO11_DUT: R326.1, R327.1, S302.4, S303.4; also elsewhere on the board
/U_Connectors/IO11_PLAT: R327.2, S303.13; also elsewhere on the board
/U_Connectors/IO12_DUT: R350.1, R351.1, S302.5, S303.5; also elsewhere on the board
/U_Connectors/IO12_PLAT: R351.2, S303.12; also elsewhere on the board
/U_Connectors/IO13_DUT: R346.1, R347.1, S302.6, S303.6; also elsewhere on the board
/U_Connectors/IO13_PLAT: R347.2, S303.11; also elsewhere on the board
/U_Connectors/IO14_DUT: R342.1, R343.1, S302.7, S303.7; also elsewhere on the board
/U_Connectors/IO14_PLAT: R343.2, S303.10; also elsewhere on the board
/U_Connectors/IO15_DUT: R340.1, R341.1, S302.8, S303.8; also elsewhere on the board
/U_Connectors/IO15_PLAT: R341.2, S303.9; also elsewhere on the board
/U_Connectors/IO_SMA0: R344.1, R348.2; also elsewhere on the board
/U_Connectors/IO_SMA1: R345.1, R349.2; also elsewhere on the board
/U_Connectors/IO_SMA2: R336.1, R338.2; also elsewhere on the board
/U_Connectors/IO_SMA3: R337.1, R339.2; also elsewhere on the board
/U_Connectors/TEARING: R300.1, R301.2; also elsewhere on the board
GND: CN300.2, CN300.3, CN301.2, CN301.3, CN302.2, CN302.3, CN303.2, CN303.3, CN304.2, CN304.3, CN305.2, CN305.3, CN306.2, CN306.3, CN309.2, CN309.3, CN310.2, CN310.3, CN311.2, CN311.3, CN312.2, CN312.3, R301.1, R338.1, R339.1, R348.1, R349.1; also elsewhere on the board
unnamed: CN300.1, R300.2, THP300.1
unnamed: CN301.1, R302.2, THP301.1
unnamed: CN302.1, R303.2, THP302.1
unnamed: CN303.1, R310.2, THP303.1
unnamed: CN304.1, R311.2, THP304.1
unnamed: CN305.1, R314.2, THP305.1
unnamed: CN306.1, R315.2, THP306.1
unnamed: CN309.1, R336.2, THP309.1
unnamed: CN310.1, R337.2, THP310.1
unnamed: CN311.1, R344.2, THP311.1
unnamed: CN312.1, R345.2, THP312.1

Notes on the sheet:
Sheet
DUT IOs SMA connectors
Drawn by:
Tearing SMA connector
GPIO SMA connectors
Glitch protection
${ELECDRAWN}
Ledger SAS
${REV}
${CURRENT_DATE}
https://www.ledger.com/
Revision:
Title:
1 rue du Mail
Approved by:
DUT to platform DIP switch
${NOM_PROJET}
Size:
${##}
Date:
${#}
${ELECAPPROVED}
75002 Paris, France

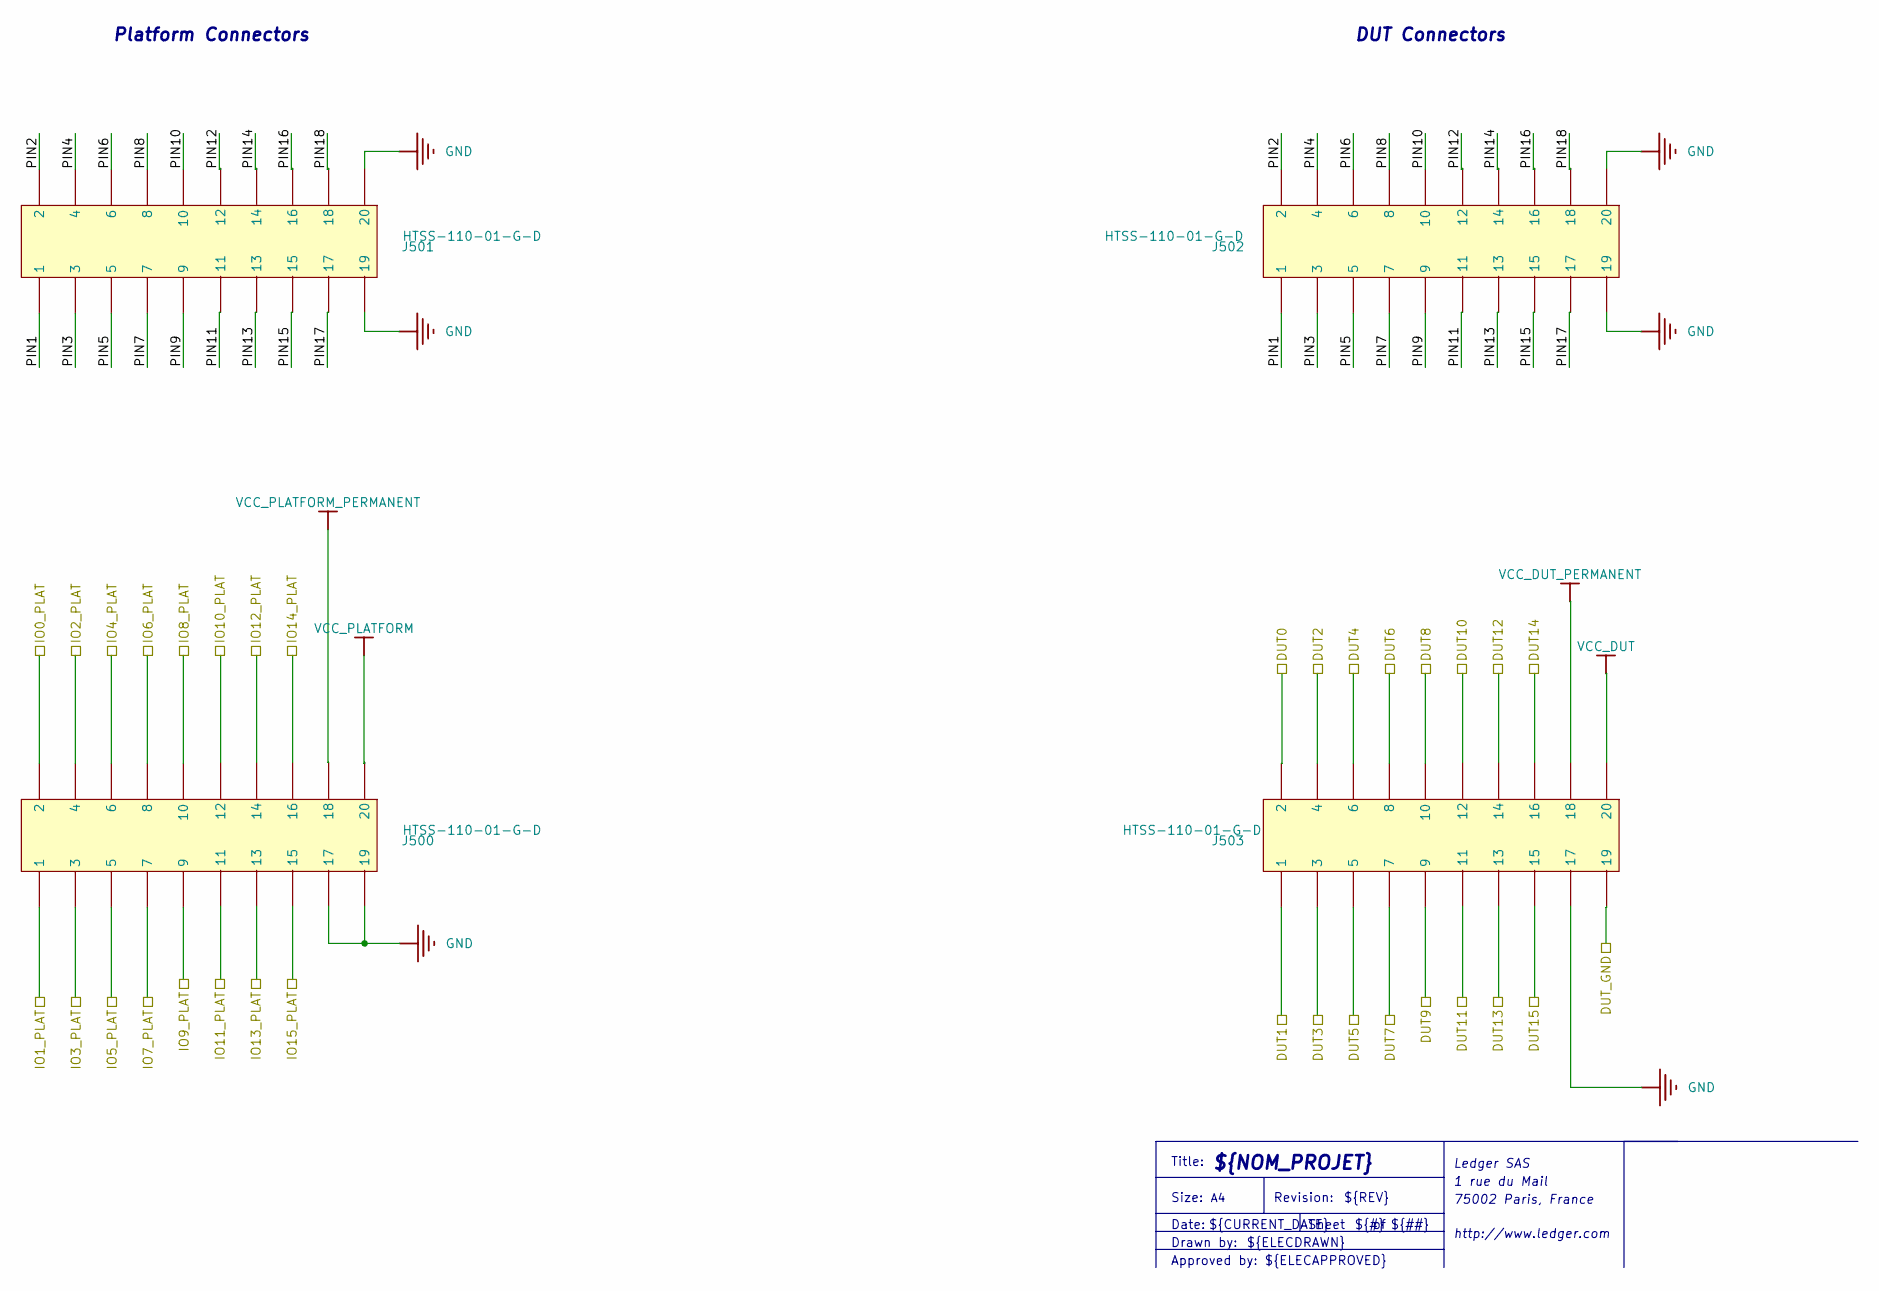
[picture p2: schematic DUT_Platform.kicad_sch]

Parts:
J500, J501, J502, J503: HTSS-110-01-G-D; SAMTEC_HTSS-110-01-G-D; MANUFACTURER PN HTSS-110-01-G-D

Connections:
/DUT_D0: J503.2; also elsewhere on the board
/DUT_D1: J503.1; also elsewhere on the board
/DUT_D2: J503.4; also elsewhere on the board
/U_Connectors/DUT3: J503.3; also elsewhere on the board
/U_Connectors/DUT4: J503.6; also elsewhere on the board
/U_Connectors/DUT5: J503.5; also elsewhere on the board
/U_Connectors/DUT6: J503.8; also elsewhere on the board
/U_Connectors/DUT7: J503.7; also elsewhere on the board
/U_Connectors/DUT8: J503.10; also elsewhere on the board
/U_Connectors/DUT9: J503.9; also elsewhere on the board
/U_Connectors/DUT10: J503.12; also elsewhere on the board
/U_Connectors/DUT11: J503.11; also elsewhere on the board
/U_Connectors/DUT12: J503.14; also elsewhere on the board
/U_Connectors/DUT13: J503.13; also elsewhere on the board
/U_Connectors/DUT14: J503.16; also elsewhere on the board
/U_Connectors/DUT15: J503.15; also elsewhere on the board
/U_Connectors/IO0_PLAT: J500.2; also elsewhere on the board
/U_Connectors/IO1_PLAT: J500.1; also elsewhere on the board
/U_Connectors/IO2_PLAT: J500.4; also elsewhere on the board
/U_Connectors/IO3_PLAT: J500.3; also elsewhere on the board
/U_Connectors/IO4_PLAT: J500.6; also elsewhere on the board
/U_Connectors/IO5_PLAT: J500.5; also elsewhere on the board
/U_Connectors/IO6_PLAT: J500.8; also elsewhere on the board
/U_Connectors/IO7_PLAT: J500.7; also elsewhere on the board
/U_Connectors/IO8_PLAT: J500.10; also elsewhere on the board
/U_Connectors/IO9_PLAT: J500.9; also elsewhere on the board
/U_Connectors/IO10_PLAT: J500.12; also elsewhere on the board
/U_Connectors/IO11_PLAT: J500.11; also elsewhere on the board
/U_Connectors/IO12_PLAT: J500.14; also elsewhere on the board
/U_Connectors/IO13_PLAT: J500.13; also elsewhere on the board
/U_Connectors/IO14_PLAT: J500.16; also elsewhere on the board
/U_Connectors/IO15_PLAT: J500.15; also elsewhere on the board
/U_DUT_Platform/DUT_GND: J503.19; also elsewhere on the board
/U_DUT_Platform/PIN1: J501.1, J502.1
/U_DUT_Platform/PIN2: J501.2, J502.2
/U_DUT_Platform/PIN3: J501.3, J502.3
/U_DUT_Platform/PIN4: J501.4, J502.4
/U_DUT_Platform/PIN5: J501.5, J502.5
/U_DUT_Platform/PIN6: J501.6, J502.6
/U_DUT_Platform/PIN7: J501.7, J502.7
/U_DUT_Platform/PIN8: J501.8, J502.8
/U_DUT_Platform/PIN9: J501.9, J502.9
/U_DUT_Platform/PIN10: J501.10, J502.10
/U_DUT_Platform/PIN11: J501.11, J502.11
/U_DUT_Platform/PIN12: J501.12, J502.12
/U_DUT_Platform/PIN13: J501.13, J502.13
/U_DUT_Platform/PIN14: J501.14, J502.14
/U_DUT_Platform/PIN15: J501.15, J502.15
/U_DUT_Platform/PIN16: J501.16, J502.16
/U_DUT_Platform/PIN17: J501.17, J502.17
/U_DUT_Platform/PIN18: J501.18, J502.18
GND: J500.17, J500.19, J501.19, J501.20, J502.19, J502.20, J503.17; also elsewhere on the board
VCC_DUT: J503.20; also elsewhere on the board
VCC_DUT_PERMANENT: J503.18; also elsewhere on the board
VCC_PLATFORM: J500.20; also elsewhere on the board
VCC_PLATFORM_PERMANENT: J500.18; also elsewhere on the board

Notes on the sheet:
${NOM_PROJET}
${#}
DUT Connectors
Sheet
Revision:
Drawn by:
${ELECAPPROVED}
${REV}
http://www.ledger.com
${##}
75002 Paris, France
1 rue du Mail
${ELECDRAWN}
Ledger SAS
Date:
${CURRENT_DATE}
Approved by:
Title:
Size:
Platform Connectors

Schematic: FPGA.kicad_sch

Parts:
C100, C101: 100uF 6.3V; C_1206_3216Metric; LCSC C15008
C102, C103, C104, C105, C106, C107, C119, C120, C127, C128, C129, C130, C131, C158, C159, C160, C161: 4.7uF 10V; C_0402_1005Metric; LCSC C23733
C108, C109, C110, C111, C112, C113, C114, C115, C116, C117, C121, C122, C123, C124, C132, C133, C134, C135, C143, C144, C145, C146, C155, C156, C162, C163, C164, C165, C166, C167, C168, C169: 470nF 10V; C_0402_1005Metric; LCSC C47339
C118, C125, C126, C157: 47uF 6.3V; C_0805_2012Metric; LCSC C16780
C136: 100nF; CAP0603; TOLERANCE 10%; MANUFACTURER PN 885012206046
C137: 10uF; CAP0603; TOLERANCE 20%; MANUFACTURER PN GRM188R61C106MA73D
C151, C153, C154: 100nF; CAP0603; TOLERANCE 10%; MANUFACTURER2 PN MCCA000159
C170: 1uF 50V; C_0603_1608Metric; LCSC C15849
C171: 100nF 50V; C_0603_1608Metric; LCSC C14663
CN100: SMA - Female; SAMTEC_SMA-J-P-X-ST-EM3; MANUFACTURER PN SMA–J–P–H–ST–EM3
L100: 600R@100MHz; L_0603_1608Metric; LCSC C1002
P100: JTAG; PinHeader_1x06_P2.54mm_Vertical; MANUFACTURER PN PZ254V-11-06P; LCSC C492405
R100: 47KOhm; RES0603; TOLERANCE 1%; MANUFACTURER PN RC0603FR-0747KL
R101, R102, R103: 10k; R_0603_1608Metric; LCSC C25804
R104, R105: 4.7k; R_0603_1608Metric; LCSC C23162
R106: 330; R_0603_1608Metric; LCSC C23138
R107, R108, R109, R113: 1k; R_0603_1608Metric; LCSC C21190
R110, R111, R112: 10KOhm; RES0603; TOLERANCE 1%; MANUFACTURER PN RC0603FR-0710KL
S100: Misc - Button - WURTH 430152080826; 430152080826; RATED VOLTAGE 12 VDC; MANUFACTURER PN 430152080826
TCK100: TP; TP_001
TDI100: TP; TP_001
TDO100: TP; TP_001
TMS100: TP; TP_001
TP100, TP101, TP102, TP103, TP104, TP105, TP106, TP107, TP108, TP111: TP; TP_001
U100: XC7A35T-1CSG324I; Xilinx_CSG324; MANUFACTURER PN XC7A35T-1CSG324I; LCSC C1521726
U105: W25Q128JVSIQ; SOIC-8_5.3x5.3mm_P1.27mm; MANUFACTURER PN W25Q128JVSIQ; LCSC C97521
Y100: Oscillator - 25MHz - 3.3V - HCMOS - ECS-2520S33-2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; XTAL_2520; MANUFACTURER PN ECS-2520S33-250-FN-TR; LCSC C2441341

Connections:
1V0: C100.1, C101.1, C102.1, C103.1, C104.1, C105.1, C106.1, C107.1, C108.1, C109.1, C110.1, C111.1, C112.1, C113.1, C114.1, C115.1, C116.1, C117.1, U100.F8 (VCCINT), U100.F10 (VCCBRAM), U100.G7 (VCCINT), U100.G9 (VCCINT), U100.G11 (VCCBRAM), U100.H8 (VCCINT), U100.J7 (VCCINT), U100.J11 (VCCINT), U100.K8 (VCCINT), U100.L7 (VCCINT), U100.L11 (VCCINT), U100.M8 (VCCINT), U100.M10 (VCCINT), U100.N7 (VCCINT), U100.N9 (VCCINT), U100.N11 (VCCINT); also elsewhere on the board
1V8: C118.1, C119.1, C120.1, C121.1, C122.1, C123.1, C124.1, L100.1, U100.F12 (VCCAUX), U100.H12 (VCCAUX), U100.K12 (VCCAUX), U100.M12 (VCCAUX); also elsewhere on the board
3V3_FPGA: C125.1, C126.1, C127.1, C128.1, C129.1, C130.1, C131.1, C132.1, C133.1, C134.1, C135.1, C136.1, C143.1, C144.1, C145.1, C146.1, C151.2, C153.2, C154.2, C155.1, C156.1, P100.1, R100.2, R101.1, R102.1, R103.1, R104.1, R105.1, R106.1, R107.1, R113.1, U100.A17 (VCCO_15), U100.B10 (VCCO_16), U100.C13 (VCCO_15), U100.D16 (VCCO_15), U100.G15 (VCCO_15), U100.H18 (VCCO_15), U100.K14 (VCCO_15), U100.L17 (VCCO_14), U100.N13 (VCCO_14), U100.P8 (CFGBVS_0), U100.P16 (VCCO_14), U100.R9 (VCCO_0), U100.T12 (VCCO_14), U100.U15 (VCCO_14), U100.V18 (VCCO_14), U105.8 (VCC), Y100.1 (EN), Y100.4 (VDD); also elsewhere on the board
/DUT_D0: R110.2; also elsewhere on the board
/DUT_D1: R111.2; also elsewhere on the board
/DUT_D2: R112.1; also elsewhere on the board
/U_Connectors/IO0_DUT: U100.A1 (IO_L9N_T1_DQS_AD7N_35); also elsewhere on the board
/U_Connectors/IO0_PLAT: U100.L1 (IO_L1P_T0_34); also elsewhere on the board
/U_Connectors/IO1_DUT: U100.A3 (IO_L8N_T1_AD14N_35); also elsewhere on the board
/U_Connectors/IO1_PLAT: U100.M1 (IO_L1N_T0_34); also elsewhere on the board
/U_Connectors/IO2_DUT: U100.A4 (IO_L8P_T1_AD14P_35); also elsewhere on the board
/U_Connectors/IO2_PLAT: U100.N1 (IO_L3N_T0_DQS_34); also elsewhere on the board
/U_Connectors/IO3_DUT: U100.A5 (IO_L3N_T0_DQS_AD5N_35); also elsewhere on the board
/U_Connectors/IO3_PLAT: U100.R1 (IO_L17P_T2_34); also elsewhere on the board
/U_Connectors/IO4_DUT: U100.A6 (IO_L3P_T0_DQS_AD5P_35); also elsewhere on the board
/U_Connectors/IO4_PLAT: U100.T1 (IO_L17N_T2_34); also elsewhere on the board
/U_Connectors/IO5_DUT: U100.B1 (IO_L9P_T1_DQS_AD7P_35); also elsewhere on the board
/U_Connectors/IO5_PLAT: U100.U1 (IO_L7P_T1_34); also elsewhere on the board
/U_Connectors/IO6_DUT: U100.C1 (IO_L16N_T2_35); also elsewhere on the board
/U_Connectors/IO6_PLAT: U100.V1 (IO_L7N_T1_34); also elsewhere on the board
/U_Connectors/IO7_DUT: U100.E1 (IO_L18N_T2_35); also elsewhere on the board
/U_Connectors/IO7_PLAT: U100.V2 (IO_L9N_T1_DQS_34); also elsewhere on the board
/U_Connectors/IO8_DUT: U100.F1 (IO_L18P_T2_35); also elsewhere on the board
/U_Connectors/IO8_PLAT: U100.V4 (IO_L10N_T1_34); also elsewhere on the board
/U_Connectors/IO9_DUT: U100.G1 (IO_L17N_T2_35); also elsewhere on the board
/U_Connectors/IO9_PLAT: U100.V5 (IO_L10P_T1_34); also elsewhere on the board
/U_Connectors/IO10_DUT: U100.H1 (IO_L17P_T2_35); also elsewhere on the board
/U_Connectors/IO10_PLAT: U100.V6 (IO_L20N_T3_34); also elsewhere on the board
/U_Connectors/IO11_DUT: U100.K1 (IO_L23N_T3_35); also elsewhere on the board
/U_Connectors/IO11_PLAT: U100.V7 (IO_L20P_T3_34); also elsewhere on the board
/U_Connectors/IO12_DUT: U100.B2 (IO_L10N_T1_AD15N_35); also elsewhere on the board
/U_Connectors/IO12_PLAT: U100.V9 (IO_L21N_T3_DQS_34); also elsewhere on the board
/U_Connectors/IO13_DUT: U100.B3 (IO_L10P_T1_AD15P_35); also elsewhere on the board
/U_Connectors/IO13_PLAT: U100.M2 (IO_L4N_T0_34); also elsewhere on the board
/U_Connectors/IO14_DUT: U100.B4 (IO_L7N_T1_AD6N_35); also elsewhere on the board
/U_Connectors/IO14_PLAT: U100.N2 (IO_L3P_T0_DQS_34); also elsewhere on the board
/U_Connectors/IO15_DUT: U100.B6 (IO_L2N_T0_AD12N_35); also elsewhere on the board
/U_Connectors/IO15_PLAT: U100.P2 (IO_L15P_T2_DQS_34); also elsewhere on the board
/U_Connectors/TEARING: U100.B13 (IO_L2P_T0_AD8P_15); also elsewhere on the board
/U_FPGA/CLK_25M: TP101.1, U100.C15 (IO_L12N_T1_MRCC_15), Y100.3 (OUT)
/U_FPGA/CLK_EXT: CN100.1, U100.G16 (IO_L13N_T2_MRCC_15)
/U_FPGA/DIR_A0: U100.G18 (IO_L22P_T3_A17_15); also elsewhere on the board
/U_FPGA/DIR_A1: U100.J18 (IO_L23N_T3_FWE_B_15); also elsewhere on the board
/U_FPGA/DIR_A2: U100.B11 (IO_L4P_T0_15); also elsewhere on the board
/U_FPGA/DIR_A3: U100.B12 (IO_L3N_T0_DQS_AD1N_15); also elsewhere on the board
/U_FPGA/DONE: R106.2, U100.P10 (DONE_0)
/U_FPGA/EN_VCC_DUT: U100.B16 (IO_L7P_T1_AD2P_15); also elsewhere on the board
/U_FPGA/EN_VCC_PLATFORM: U100.B14 (IO_L2N_T0_AD8N_15); also elsewhere on the board
/U_FPGA/FLASH_CLK: U100.E9 (CCLK_0), U105.6 (CLK)
/U_FPGA/FLASH_CS: R101.2, U100.L13 (IO_L6P_T0_FCS_B_14), U105.1 (~CS)
/U_FPGA/FLASH_IO0: U100.K17 (IO_L1P_T0_D00_MOSI_14), U105.5 (DI/IO_{0})
/U_FPGA/FLASH_IO1: U100.K18 (IO_L1N_T0_D01_DIN_14), U105.2 (DO/IO_{1})
/U_FPGA/FLASH_IO2: R102.2, U100.L14 (IO_L2P_T0_D02_14), U105.3 (~WP/IO_{2})
/U_FPGA/FLASH_IO3: R103.2, U100.M14 (IO_L2N_T0_D03_14), U105.7 (~HOLD/~RESET/IO_{3})
/U_FPGA/INIT_B: R105.2, TP111.1, U100.P7 (INIT_B_0)
/U_FPGA/IO_A0: U100.B18 (IO_L10P_T1_AD11P_15); also elsewhere on the board
/U_FPGA/IO_A1: U100.D18 (IO_L21N_T3_DQS_A18_15); also elsewhere on the board
/U_FPGA/IO_A2: U100.E18 (IO_L21P_T3_DQS_15); also elsewhere on the board
/U_FPGA/IO_A3: U100.F18 (IO_L22N_T3_A16_15); also elsewhere on the board
/U_FPGA/JTAG_TCK: P100.3, TCK100.1, U100.E10 (TCK_0)
/U_FPGA/JTAG_TDI: P100.5, TDI100.1, U100.E11 (TDI_0)
/U_FPGA/JTAG_TDO: P100.4, TDO100.1, U100.E13 (TDO_0)
/U_FPGA/JTAG_TMS: P100.6, TMS100.1, U100.E12 (TMS_0)
/U_FPGA/LED_CLK: U100.A13 (IO_L9P_T1_DQS_AD3P_15); also elsewhere on the board
/U_FPGA/LED_LE: U100.A14 (IO_L9N_T1_DQS_AD3N_15); also elsewhere on the board
/U_FPGA/LED_SDI: U100.A15 (IO_L8P_T1_AD10P_15); also elsewhere on the board
/U_FPGA/LED_SDO: U100.A16 (IO_L8N_T1_AD10N_15); also elsewhere on the board
/U_FPGA/LED_/OE: U100.A18 (IO_L10N_T1_AD11N_15); also elsewhere on the board
/U_FPGA/MODE_M0: R107.2, U100.P12 (M0_0)
/U_FPGA/MODE_M1: R108.1, U100.P13 (M1_0)
/U_FPGA/MODE_M2: R109.1, U100.P11 (M2_0)
/U_FPGA/PROGRAM_B: R104.2, U100.P9 (PROGRAM_B_0)
/U_FPGA/PUDC_B: R113.2, U100.L15 (IO_L3P_T0_DQS_PUDC_B_14)
/U_FPGA/PULL_D0: R110.1, U100.B7 (IO_L2P_T0_AD12P_35)
/U_FPGA/PULL_D1: R111.1, U100.C2 (IO_L16P_T2_35)
/U_FPGA/PULL_D2: R112.2, U100.D2 (IO_L14N_T2_SRCC_35)
/U_FPGA/RESET_N: C137.2, R100.1, S100.1, S100.3, TP100.1, U100.A11 (IO_L4N_T0_15)
/U_FPGA/RXD: U100.M18 (IO_L4N_T0_D05_14); also elsewhere on the board
/U_FPGA/SPARE_0: TP102.1, U100.T18 (IO_L7N_T1_D10_14)
/U_FPGA/SPARE_1: TP103.1, U100.U18 (IO_L17N_T2_A13_D29_14)
/U_FPGA/SPARE_2: TP104.1, U100.V10 (IO_L21P_T3_DQS_14)
/U_FPGA/SPARE_3: TP105.1, U100.V11 (IO_L21N_T3_DQS_A06_D22_14)
/U_FPGA/SPARE_4: TP106.1, U100.V12 (IO_L20N_T3_A07_D23_14)
/U_FPGA/SPARE_5: TP107.1, U100.V14 (IO_L22N_T3_A04_D20_14)
/U_FPGA/SPARE_6: TP108.1, U100.V15 (IO_L16P_T2_CSI_B_14)
/U_FPGA/TXD: U100.L18 (IO_L4P_T0_D04_14); also elsewhere on the board
GND: C100.2, C101.2, C102.2, C103.2, C104.2, C105.2, C106.2, C107.2, C108.2, C109.2, C110.2, C111.2, C112.2, C113.2, C114.2, C115.2, C116.2, C117.2, C118.2, C119.2, C120.2, C121.2, C122.2, C123.2, C124.2, C125.2, C126.2, C127.2, C128.2, C129.2, C130.2, C131.2, C132.2, C133.2, C134.2, C135.2, C136.2, C137.1, C143.2, C144.2, C145.2, C146.2, C151.1, C153.1, C154.1, C155.2, C156.2, C157.2, C158.2, C159.2, C160.2, C161.2, C162.2, C163.2, C164.2, C165.2, C166.2, C167.2, C168.2, C169.2, C170.2, C171.2, CN100.2, CN100.3, P100.2, R108.2, R109.2, S100.2, S100.4, U100.A2 (GND), U100.A12 (GND), U100.B5 (GND), U100.B15 (GND), U100.C8 (GND), U100.C18 (GND), U100.D1 (GND), U100.D11 (GND), U100.E4 (GND), U100.E8 (VCCBATT_0), U100.E14 (GND), U100.F7 (GND), U100.F9 (GND), U100.F11 (GND), U100.F17 (GND), U100.G8 (GND), U100.G10 (GND), U100.G12 (GND), U100.H3 (GND), U100.H7 (GND), U100.H9 (GNDADC_0), U100.H11 (GND), U100.H13 (GND), U100.J6 (GND), U100.J8 (GND), U100.J9 (VREFN_0), U100.J10 (VP_0), U100.J12 (GND), U100.J16 (GND), U100.K7 (GND), U100.K9 (VN_0), U100.K10 (VREFP_0), U100.K11 (GND), U100.L2 (GND), U100.L8 (GND), U100.L9 (DXN_0), U100.L10 (DXP_0), U100.L12 (GND), U100.M5 (GND), U100.M7 (GND), U100.M9 (GND), U100.M11 (GND), U100.M15 (GND), U100.N8 (GND), U100.N10 (GND), U100.N12 (GND), U100.N18 (GND), U100.P1 (GND), U100.R4 (GND), U100.R14 (GND), U100.T7 (GND), U100.T17 (GND), U100.U10 (GND), U100.V3 (GND), U100.V13 (GND), U105.4 (GND), Y100.2 (GND); also elsewhere on the board
PD_SCL: U100.P18 (IO_L9N_T1_DQS_D13_14); also elsewhere on the board
PD_SDA: U100.R18 (IO_L7P_T1_D09_14); also elsewhere on the board
VCCADC: C170.1, C171.1, L100.2, U100.H10 (VCCADC_0)
VCC_IO_FPGA: C157.1, C158.1, C159.1, C160.1, C161.1, C162.1, C163.1, C164.1, C165.1, C166.1, C167.1, C168.1, C169.1, U100.A7 (VCCO_35), U100.C3 (VCCO_35), U100.D6 (VCCO_35), U100.F2 (VCCO_35), U100.G5 (VCCO_35), U100.J1 (VCCO_35), U100.K4 (VCCO_34), U100.N3 (VCCO_34), U100.P6 (VCCO_34), U100.T2 (VCCO_34), U100.U5 (VCCO_34), U100.V8 (VCCO_34); also elsewhere on the board

Notes on the sheet:
U100 Banks 14 and 15 (3V3_FPGA)
U100 Bank 34 (VCC_IO_FPGA), VCCO_16
U100 Bank 35 (VCC_IO_FPGA)
U100 Bank 0: configuration and JTAG
U100 Power
Configuration: Master SPI x4 (M[2:0] = 001), W25Q128JV
JTAG (Digilent JTAG-HS2/HS3 6-pin header: VDD GND TCK TDO TDI TMS)
Clocks and reset
D0-D2 pull resistors, spare I/O test points
Decoupling (UG483 Table 2-2, sized for XC7A100T)
