KarpelesLab/scaffold/hw/kicad/Scaffold.kicad_pcb

## KiCad design hw/kicad/Scaffold.kicad_pcb (continued)

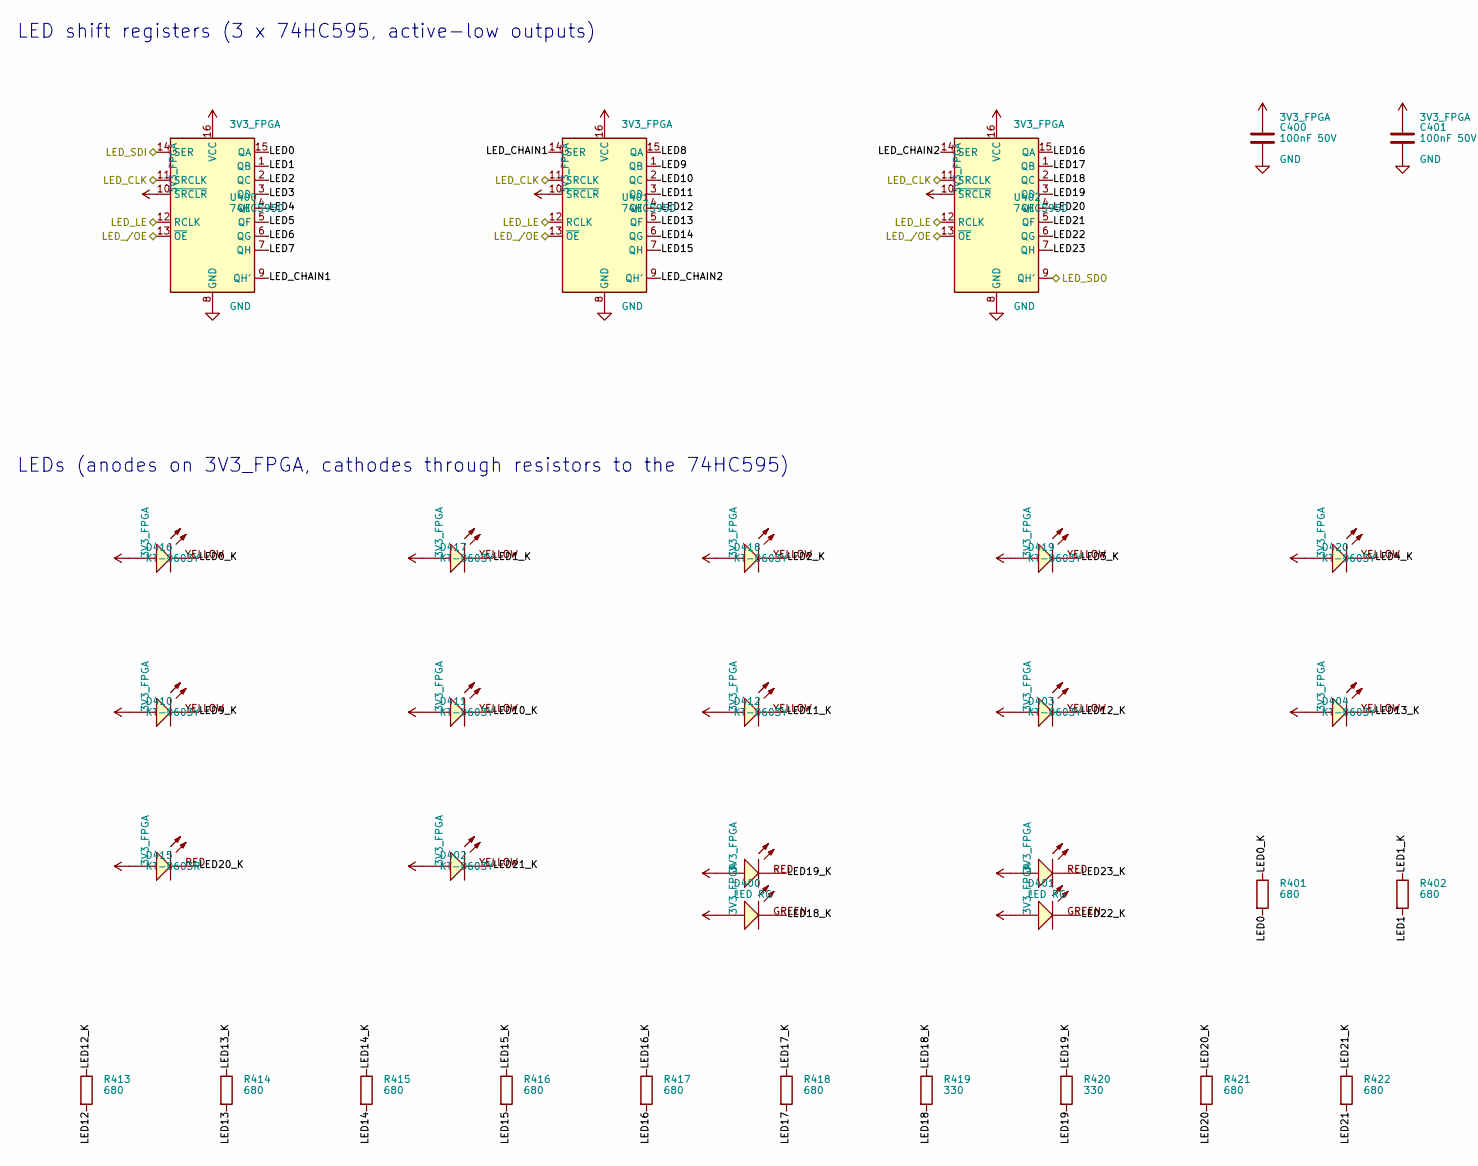
[picture p3: schematic LEDs.kicad_sch, part in row 1, column 1]

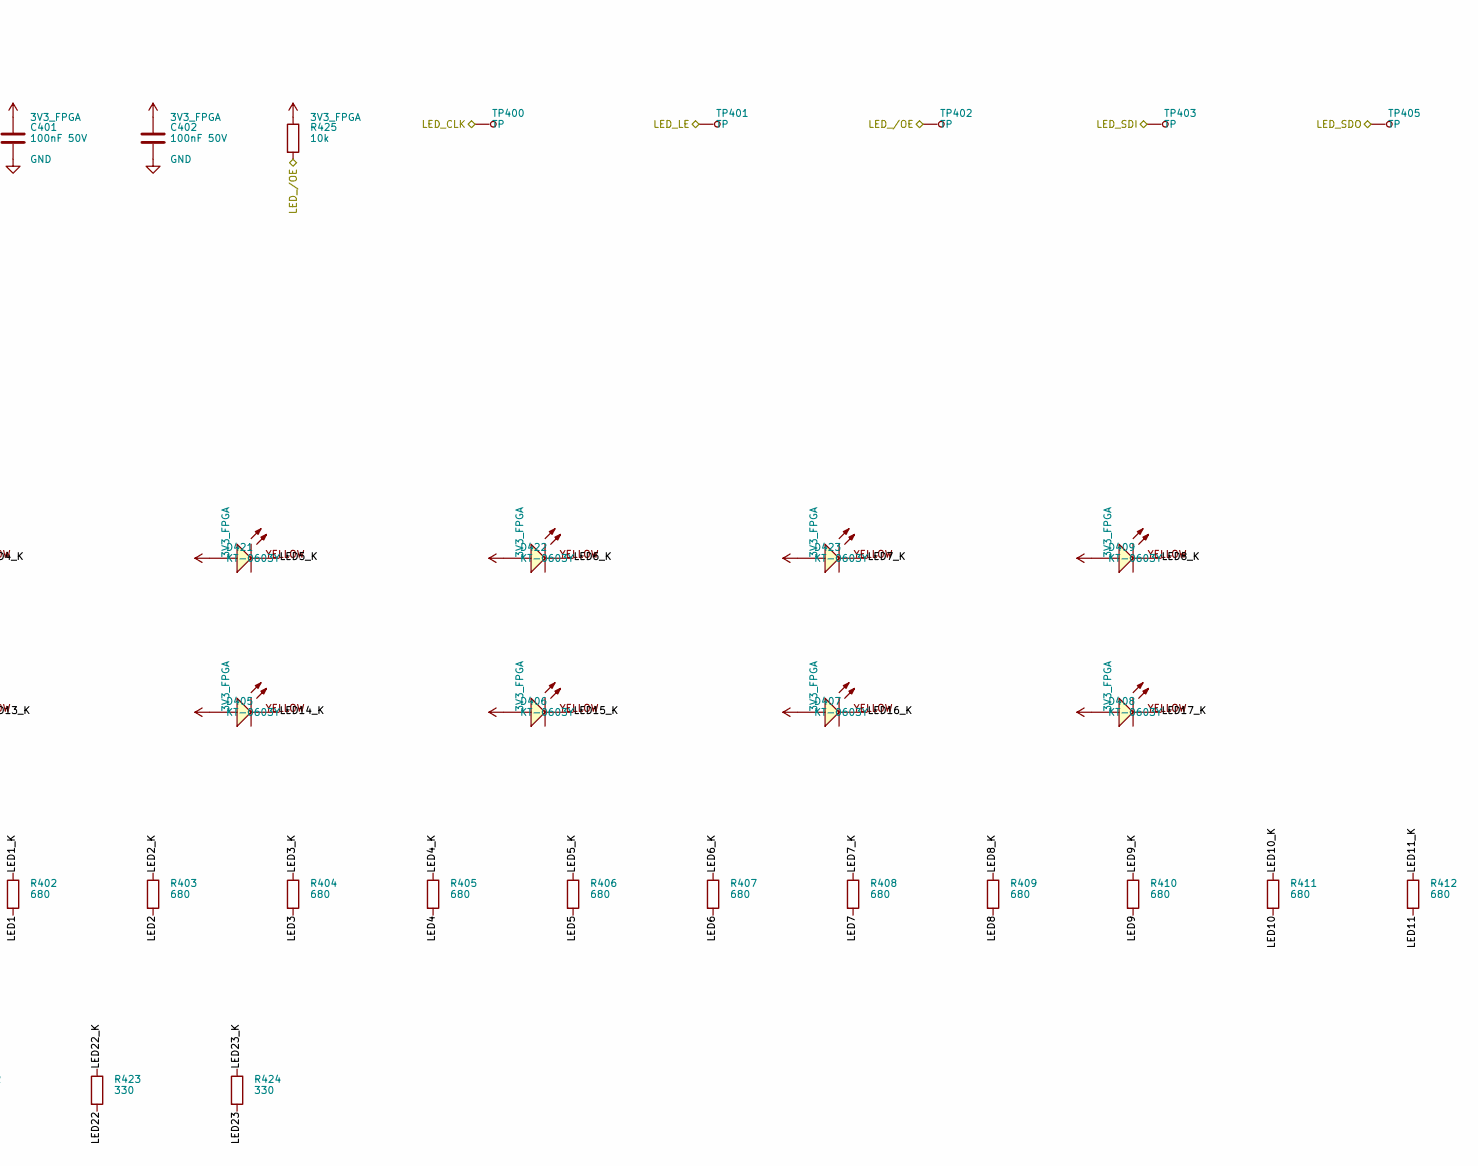
[picture p4: schematic LEDs.kicad_sch, part in row 1, column 2]

Parts:
C400, C401, C402: 100nF 50V; C_0603_1608Metric; LCSC C14663
D400, D401: LED RG; PLCC-4_3528; MANUFACTURER PN 150141RV73100; LCSC C5872444
D402, D403, D404, D405, D406, D407, D408, D409, D410, D411, D412, D416, D417, D418, D419, D420, D421, D422, D423: KT-0603Y; LED_0603_1608Metric; MANUFACTURER PN KT-0603Y; LCSC C2287
D415: KT-0603R; LED_0603_1608Metric; MANUFACTURER PN KT-0603R; LCSC C2286
R401, R402, R403, R404, R405, R406, R407, R408, R409, R410, R411, R412, R413, R414, R415, R416, R417, R418, R421, R422: 680; R_0603_1608Metric; LCSC C23228
R419, R420, R423, R424: 330; R_0603_1608Metric; LCSC C23138
R425: 10k; R_0603_1608Metric; LCSC C25804
TP400, TP401, TP402, TP403, TP405: TP; TP_001
U400, U401, U402: 74HC595D; SOIC-16_3.9x9.9mm_P1.27mm; MANUFACTURER PN 74HC595D,118; LCSC C5947

Connections:
3V3_FPGA: C400.1, C401.1, C402.1, D400.1 (AR), D400.2 (AG), D401.1 (AR), D401.2 (AG), D402.2 (A), D403.2 (A), D404.2 (A), D405.2 (A), D406.2 (A), D407.2 (A), D408.2 (A), D409.2 (A), D410.2 (A), D411.2 (A), D412.2 (A), D415.2 (A), D416.2 (A), D417.2 (A), D418.2 (A), D419.2 (A), D420.2 (A), D421.2 (A), D422.2 (A), D423.2 (A), R425.1, U400.10 (~SRCLR), U400.16 (VCC), U401.10 (~SRCLR), U401.16 (VCC), U402.10 (~SRCLR), U402.16 (VCC); also elsewhere on the board
/U_FPGA/LED_CLK: TP400.1, U400.11 (SRCLK), U401.11 (SRCLK), U402.11 (SRCLK); also elsewhere on the board
/U_FPGA/LED_LE: TP401.1, U400.12 (RCLK), U401.12 (RCLK), U402.12 (RCLK); also elsewhere on the board
/U_FPGA/LED_SDI: TP403.1, U400.14 (SER); also elsewhere on the board
/U_FPGA/LED_SDO: TP405.1, U402.9 (QH'); also elsewhere on the board
/U_FPGA/LED_/OE: R425.2, TP402.1, U400.13 (~OE), U401.13 (~OE), U402.13 (~OE); also elsewhere on the board
/U_LEDs/LED0: R401.2, U400.15 (QA)
/U_LEDs/LED0_K: D416.1 (K), R401.1
/U_LEDs/LED1: R402.2, U400.1 (QB)
/U_LEDs/LED1_K: D417.1 (K), R402.1
/U_LEDs/LED2: R403.2, U400.2 (QC)
/U_LEDs/LED2_K: D418.1 (K), R403.1
/U_LEDs/LED3: R404.2, U400.3 (QD)
/U_LEDs/LED3_K: D419.1 (K), R404.1
/U_LEDs/LED4: R405.2, U400.4 (QE)
/U_LEDs/LED4_K: D420.1 (K), R405.1
/U_LEDs/LED5: R406.2, U400.5 (QF)
/U_LEDs/LED5_K: D421.1 (K), R406.1
/U_LEDs/LED6: R407.2, U400.6 (QG)
/U_LEDs/LED6_K: D422.1 (K), R407.1
/U_LEDs/LED7: R408.2, U400.7 (QH)
/U_LEDs/LED7_K: D423.1 (K), R408.1
/U_LEDs/LED8: R409.2, U401.15 (QA)
/U_LEDs/LED8_K: D409.1 (K), R409.1
/U_LEDs/LED9: R410.2, U401.1 (QB)
/U_LEDs/LED9_K: D410.1 (K), R410.1
/U_LEDs/LED10: R411.2, U401.2 (QC)
/U_LEDs/LED10_K: D411.1 (K), R411.1
/U_LEDs/LED11: R412.2, U401.3 (QD)
/U_LEDs/LED11_K: D412.1 (K), R412.1
/U_LEDs/LED12: R413.2, U401.4 (QE)
/U_LEDs/LED12_K: D403.1 (K), R413.1
/U_LEDs/LED13: R414.2, U401.5 (QF)
/U_LEDs/LED13_K: D404.1 (K), R414.1
/U_LEDs/LED14: R415.2, U401.6 (QG)
/U_LEDs/LED14_K: D405.1 (K), R415.1
/U_LEDs/LED15: R416.2, U401.7 (QH)
/U_LEDs/LED15_K: D406.1 (K), R416.1
/U_LEDs/LED16: R417.2, U402.15 (QA)
/U_LEDs/LED16_K: D407.1 (K), R417.1
/U_LEDs/LED17: R418.2, U402.1 (QB)
/U_LEDs/LED17_K: D408.1 (K), R418.1
/U_LEDs/LED18: R419.2, U402.2 (QC)
/U_LEDs/LED18_K: D400.4 (KG), R419.1
/U_LEDs/LED19: R420.2, U402.3 (QD)
/U_LEDs/LED19_K: D400.3 (KR), R420.1
/U_LEDs/LED20: R421.2, U402.4 (QE)
/U_LEDs/LED20_K: D415.1 (K), R421.1
/U_LEDs/LED21: R422.2, U402.5 (QF)
/U_LEDs/LED21_K: D402.1 (K), R422.1
/U_LEDs/LED22: R423.2, U402.6 (QG)
/U_LEDs/LED22_K: D401.4 (KG), R423.1
/U_LEDs/LED23: R424.2, U402.7 (QH)
/U_LEDs/LED23_K: D401.3 (KR), R424.1
/U_LEDs/LED_CHAIN1: U400.9 (QH'), U401.14 (SER)
/U_LEDs/LED_CHAIN2: U401.9 (QH'), U402.14 (SER)
GND: C400.2, C401.2, C402.2, U400.8 (GND), U401.8 (GND), U402.8 (GND); also elsewhere on the board

Notes on the sheet:
LED shift registers (3 x 74HC595, active-low outputs)
LEDs (anodes on 3V3_FPGA, cathodes through resistors to the 74HC595)
