KarpelesLab/scaffold/hw/kicad/Scaffold.kicad_pcb

## KiCad design hw/kicad/Scaffold.kicad_pcb (continued)

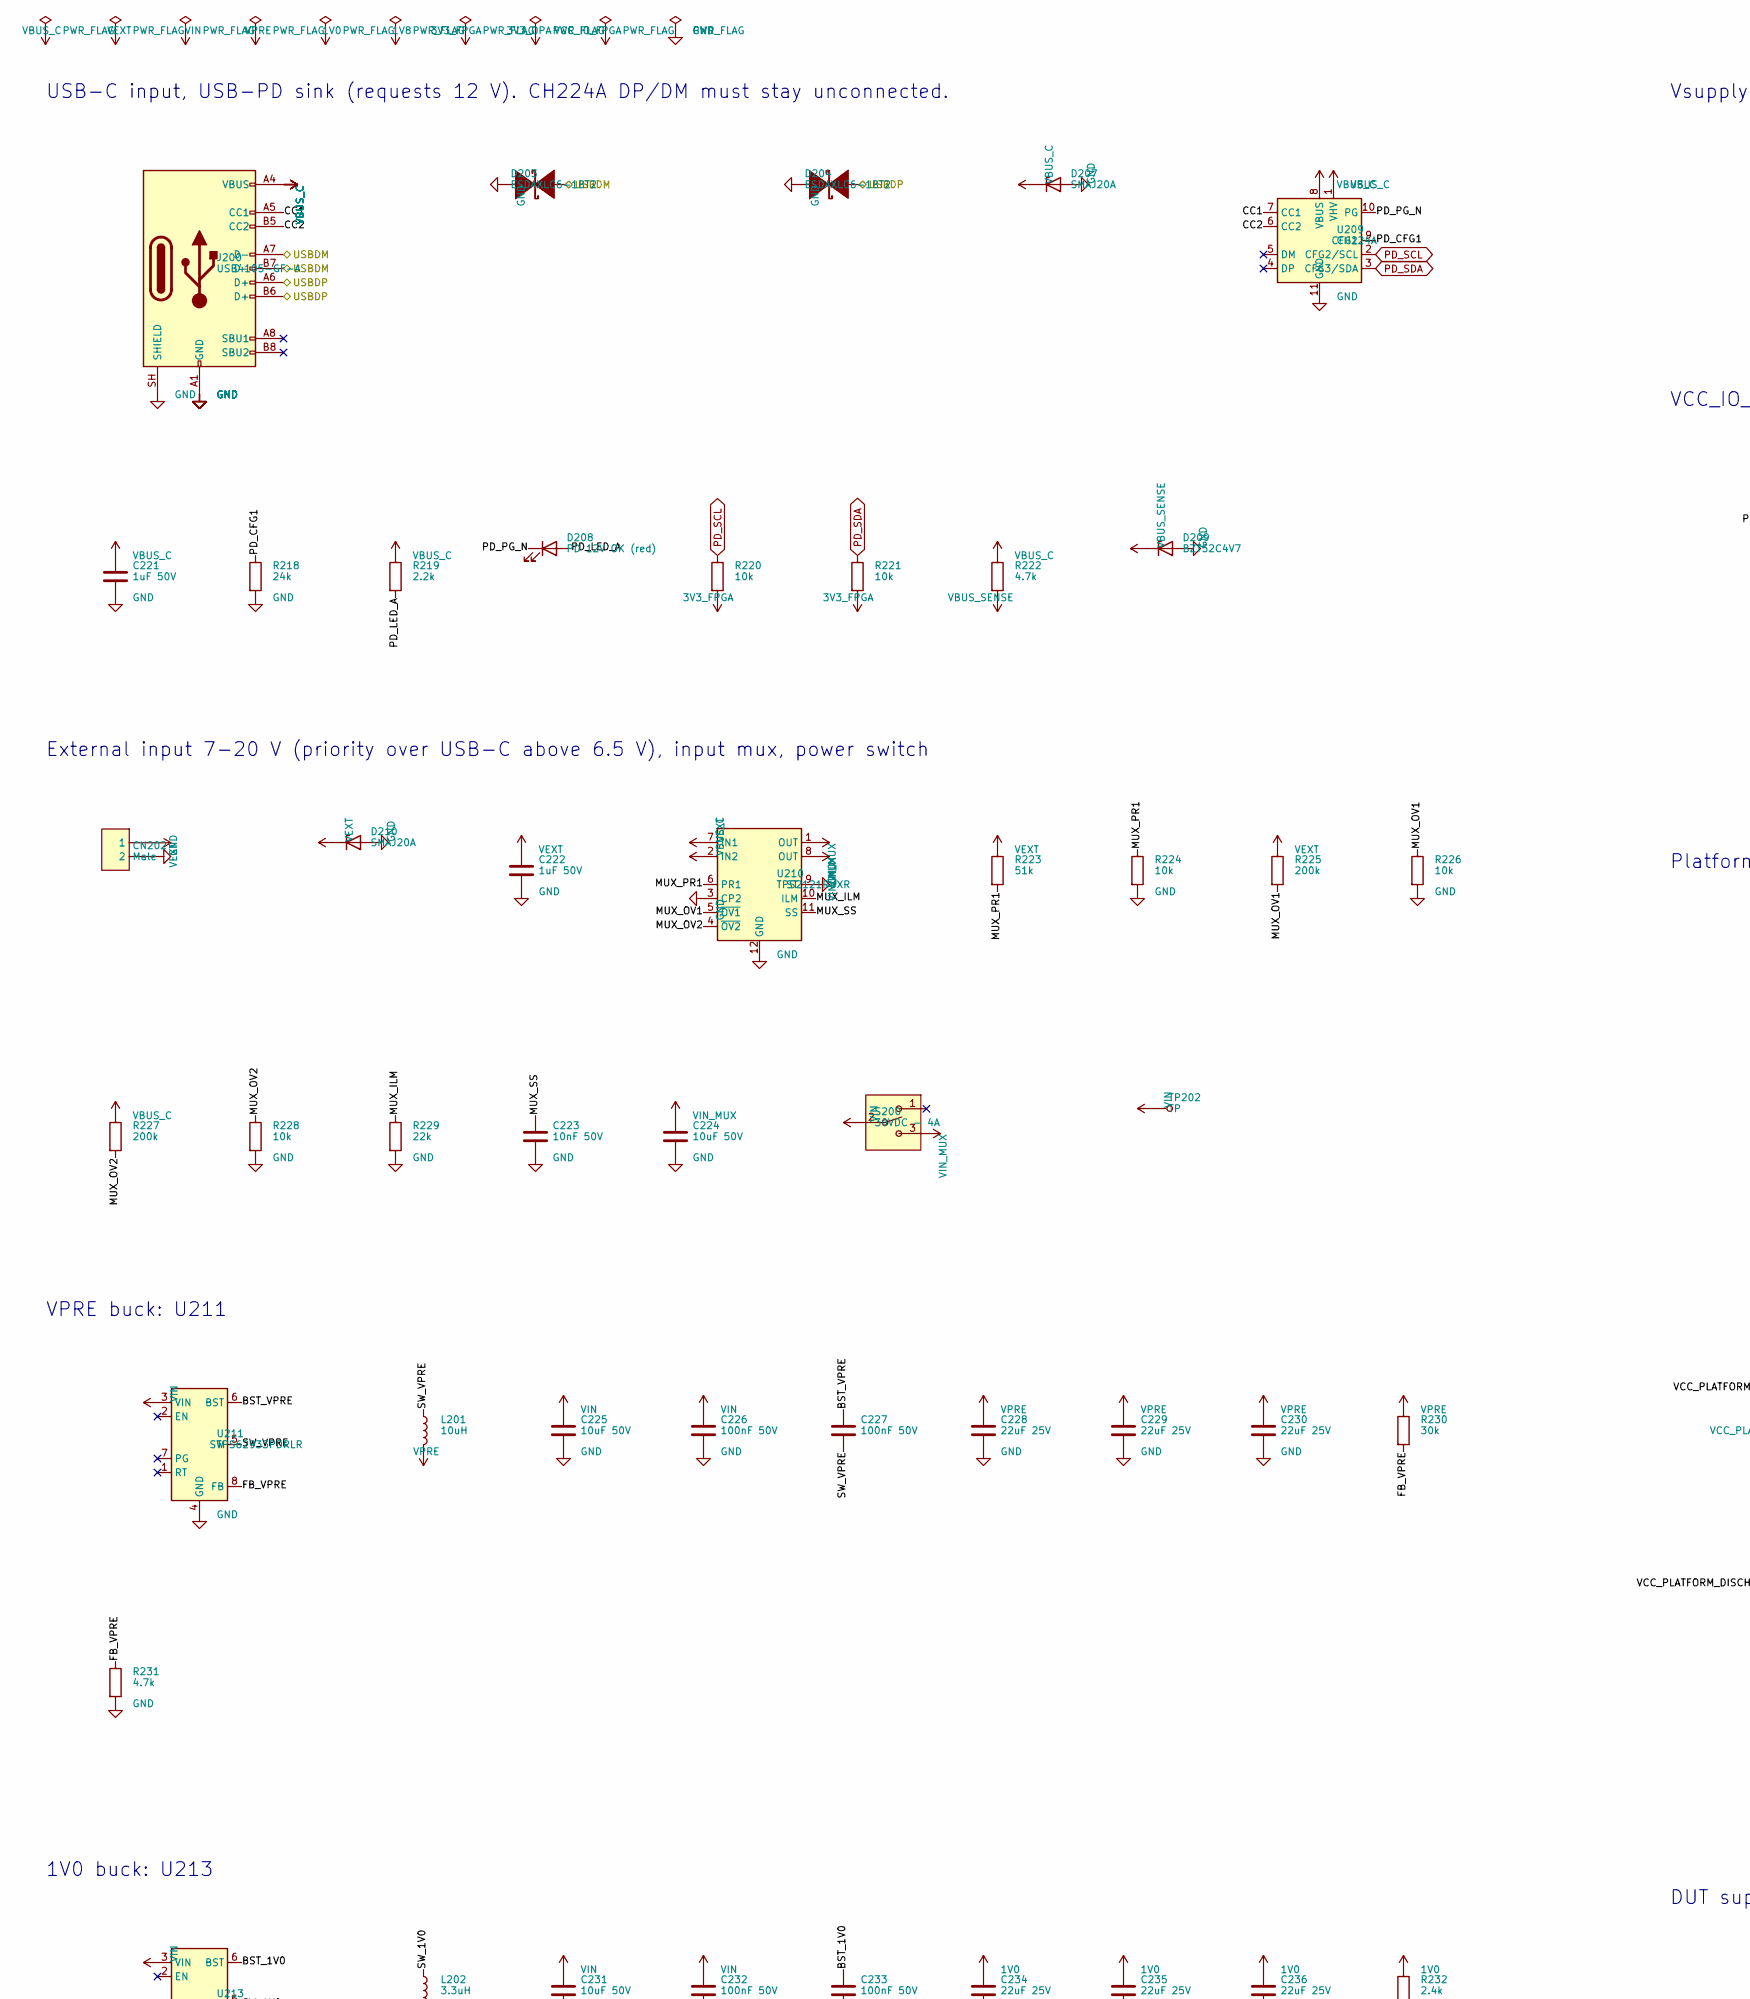
[picture p5: schematic Power.kicad_sch, part in row 1, column 1]

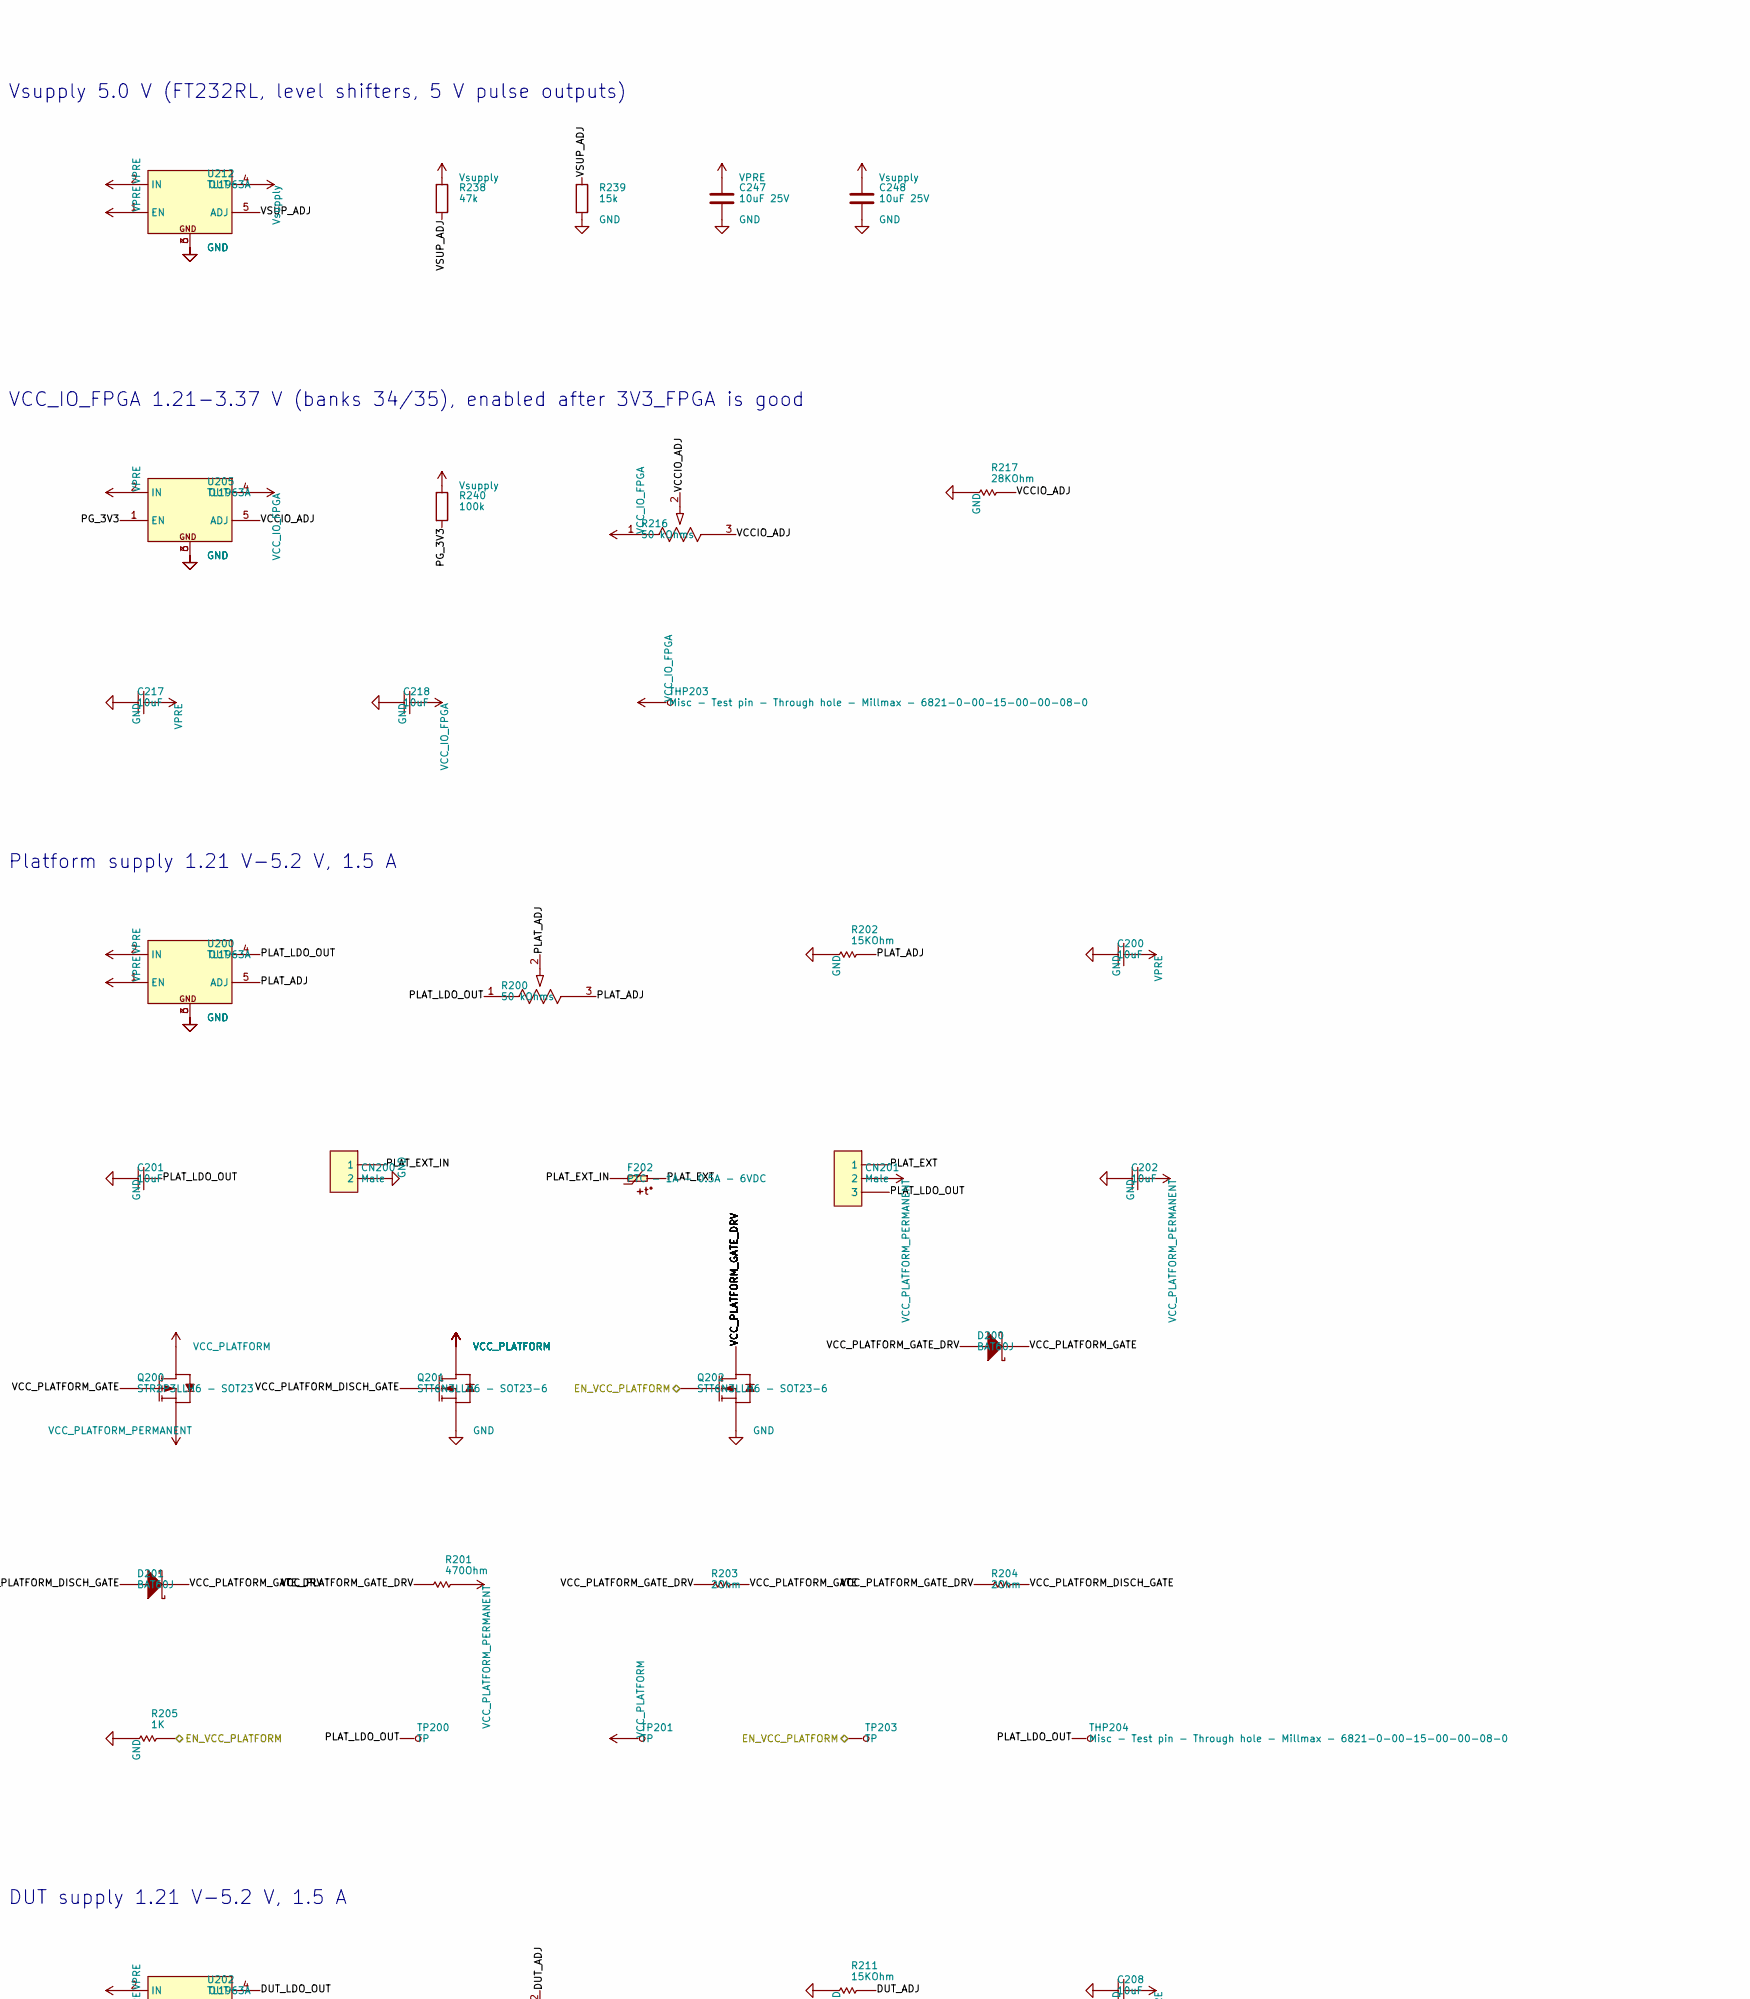
[picture p6: schematic Power.kicad_sch, part in row 1, column 2]

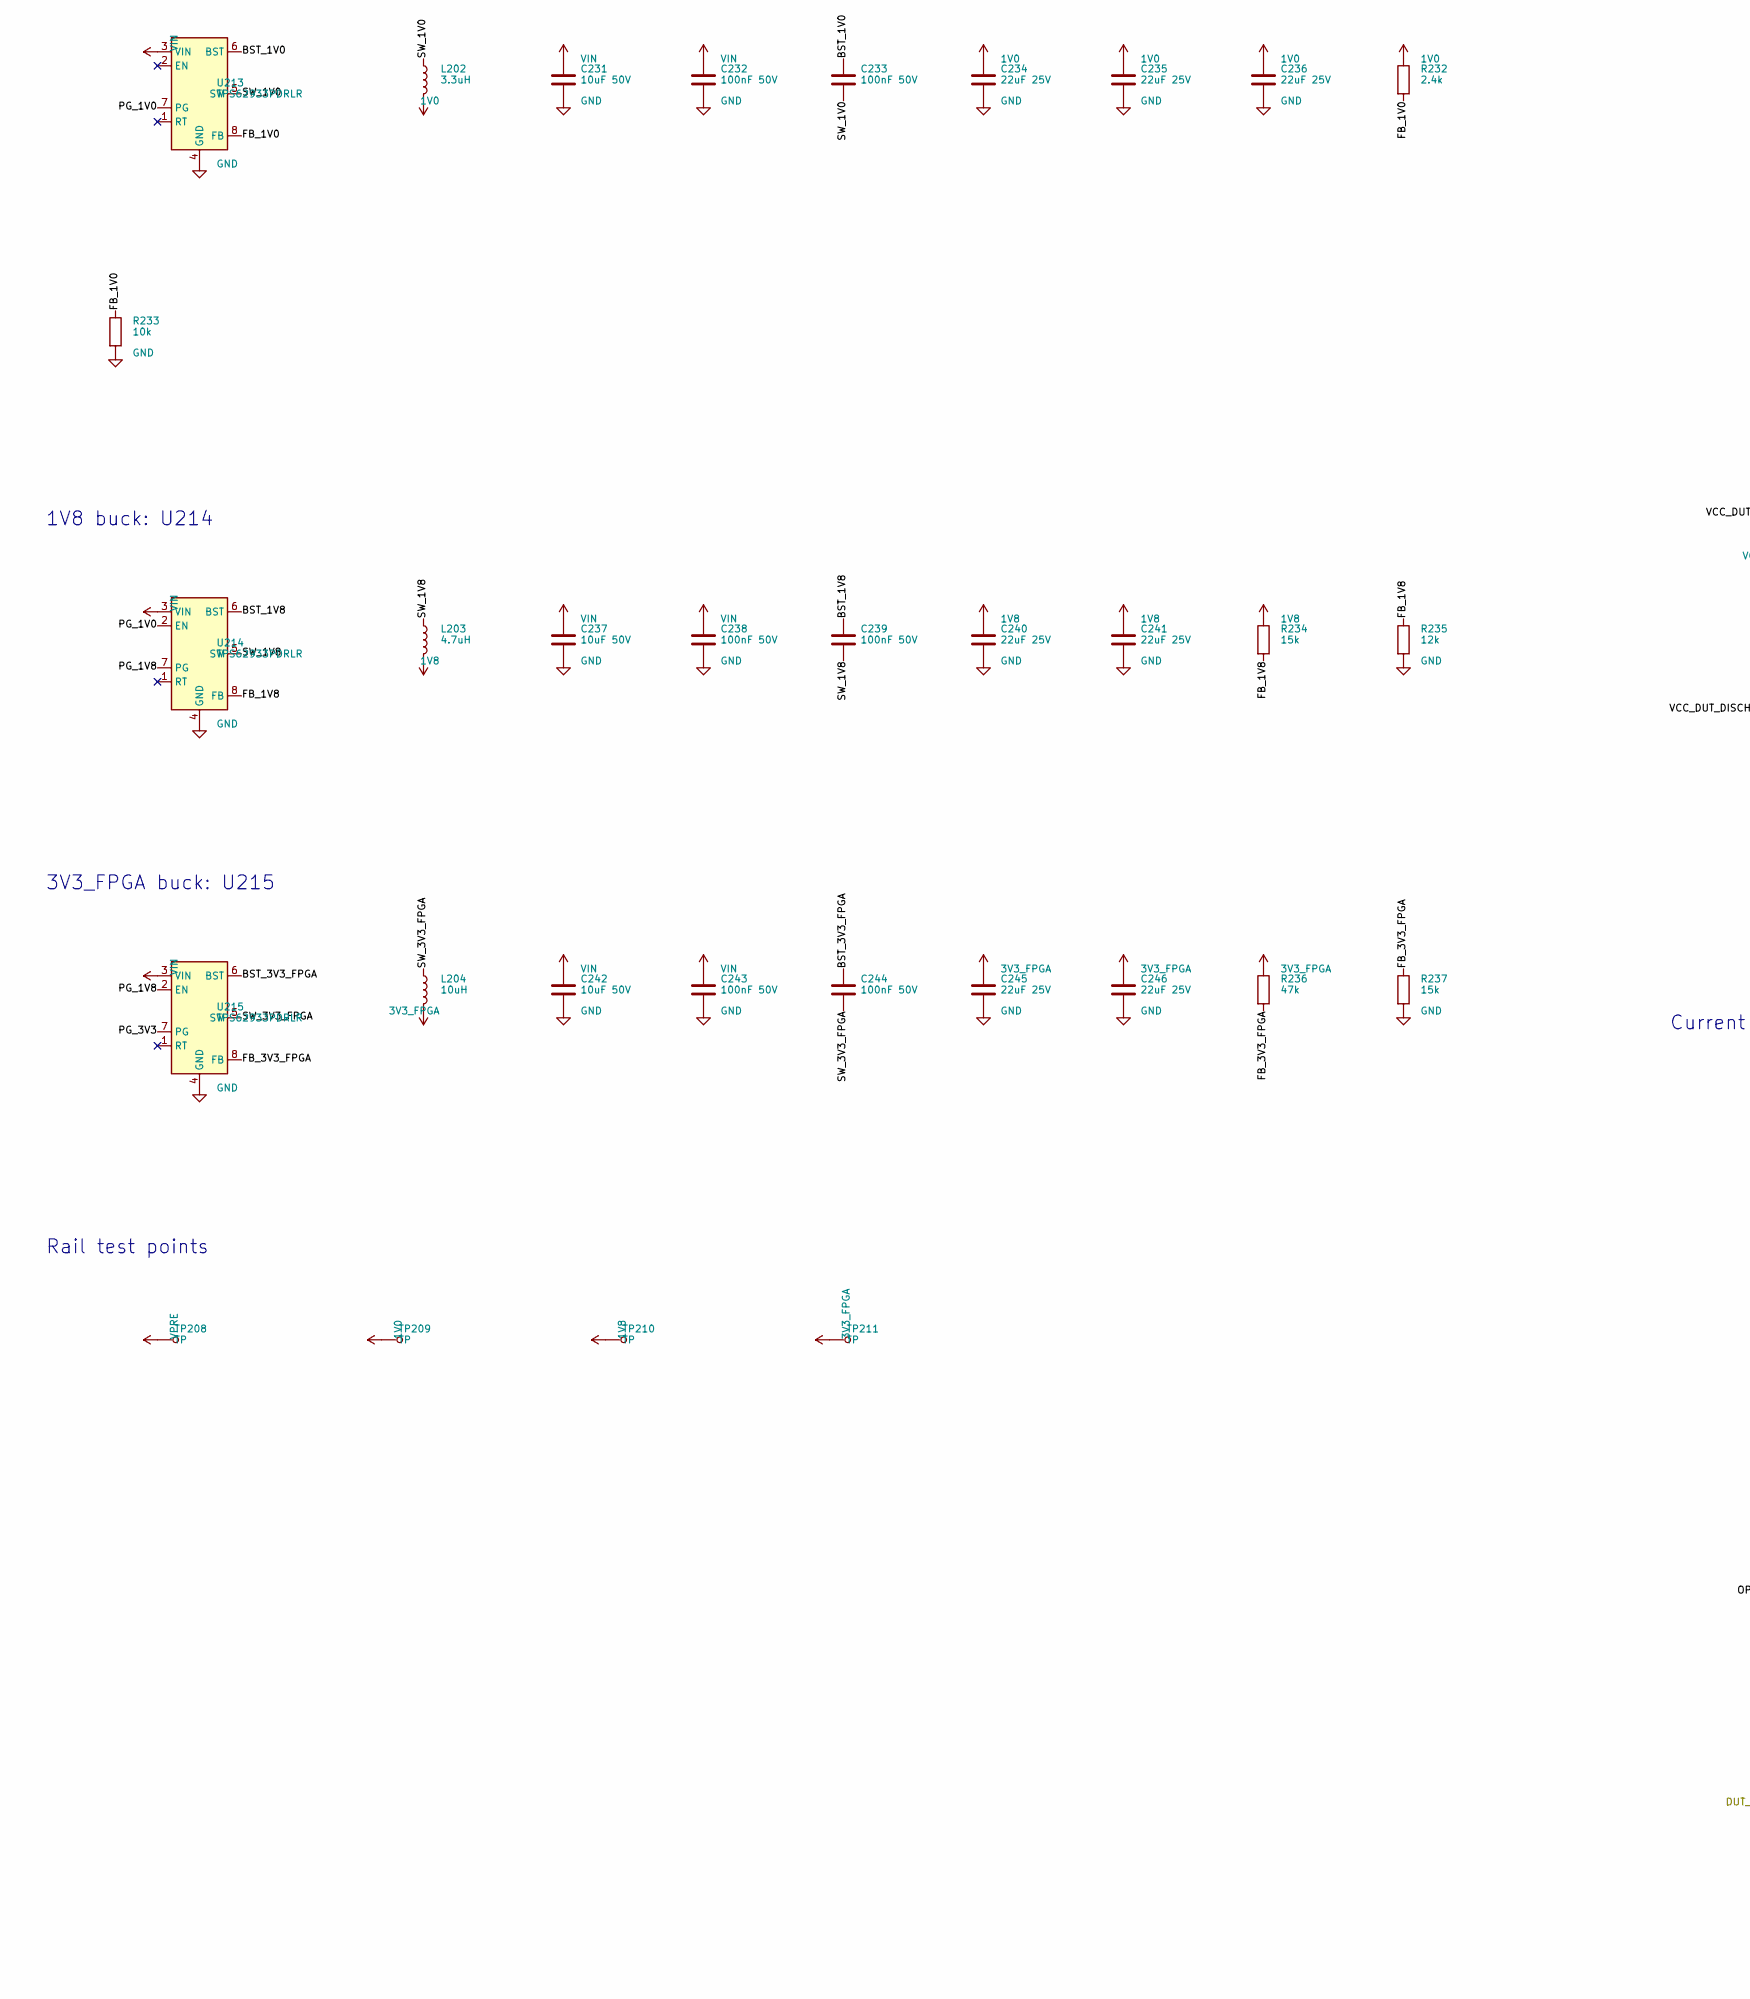
[picture p7: schematic Power.kicad_sch, part in row 2, column 1]

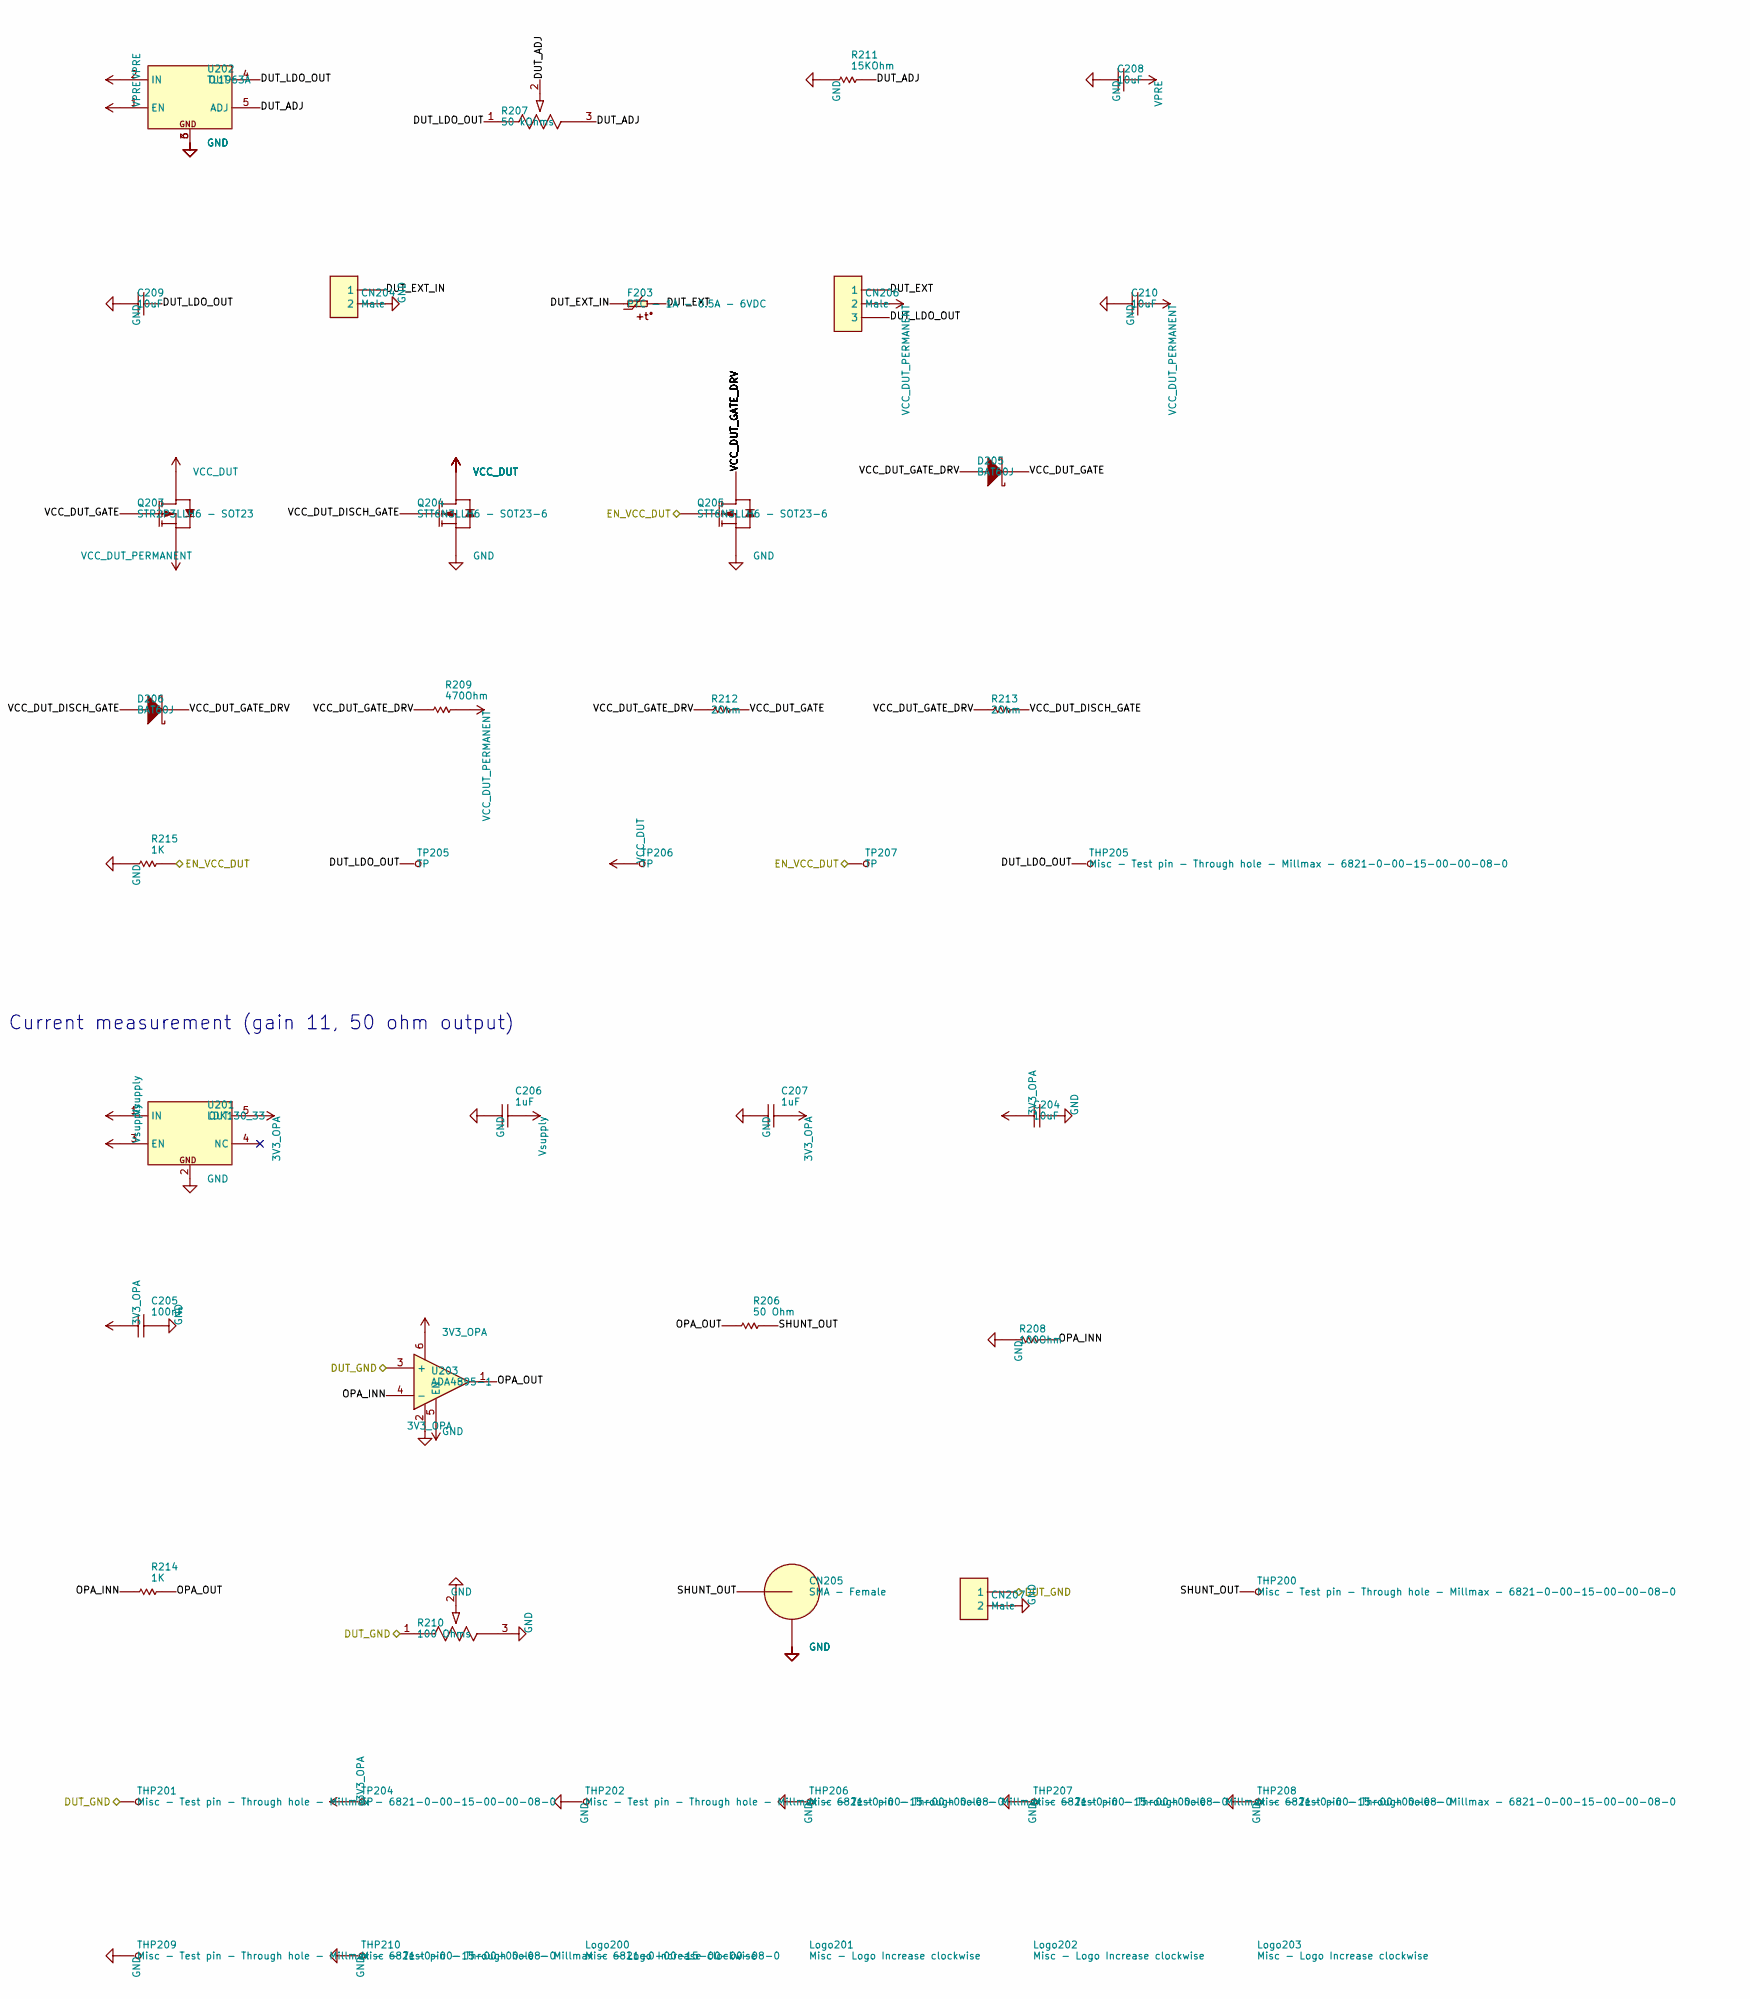
[picture p8: schematic Power.kicad_sch, part in row 2, column 2]

Parts:
C200, C201, C202, C204, C208, C209, C210, C217, C218: 10uF; CAP0603; TOLERANCE 20%; MANUFACTURER PN GRM188R61C106MA73D
C205: 100nF; CAP0603; TOLERANCE 10%; MANUFACTURER1 PN CC0603KRX7R7BB104
C206, C207: 1uF; CAP0603; TOLERANCE 10%; MANUFACTURER PN C0603C105K4RACTU
C221, C222: 1uF 50V; C_0603_1608Metric; LCSC C15849
C223: 10nF 50V; C_0603_1608Metric; LCSC C57112
C224, C225, C231, C237, C242: 10uF 50V; C_1206_3216Metric; LCSC C13585
C226, C227, C232, C233, C238, C239, C243, C244: 100nF 50V; C_0603_1608Metric; LCSC C14663
C228, C229, C230, C234, C235, C236, C240, C241, C245, C246: 22uF 25V; C_0805_2012Metric; LCSC C45783
C247, C248: 10uF 25V; C_0805_2012Metric; LCSC C15850
CN200, CN202, CN204: Male; WURTH_691213710002; MANUFACTURER PN 691213710002
CN201, CN206: Male; MOLEX_90120-0123; MANUFACTURER PN 90120-0123
CN205: SMA - Female; SAMTEC_SMA-J-P-X-ST-EM3; MANUFACTURER PN SMA–J–P–H–ST–EM3
CN207: Male; MOLEX_90120-0122; MANUFACTURER PN 90120-0122
D200, D201, D205, D206: BAT60J; SOD323_A; MANUFACTURER PN BAT60J
D203, D204: ESDAXLC6-1BT2; SOD882; MANUFACTURER PN ESDAXLC6-1BT2
D207, D210: SMAJ20A; D_SMA; LCSC C115250
D208: PD 12V OK (red); LED_0603_1608Metric; LCSC C2286
D209: BZT52C4V7; D_SOD-123; LCSC C2116
F202, F203: PTC - 1A - 0.5A - 6VDC; FUSE_0805; VOLTAGE 6V; MANUFACTURER PN 0ZCK0050FF2E
J200: USB4105-GF-A; USB_C_Receptacle_GCT_USB4105-xx-A_16P_TopMnt_Horizontal; MANUFACTURER PN USB4105-GF-A; LCSC C3020560
L201: 10uH; L_CJiang_FXL1040; LCSC C475915
L202: 3.3uH; L_Changjiang_FNR6045S; LCSC C168063
L203: 4.7uH; L_Changjiang_FNR6045S; LCSC C168067
L204: 10uH; L_Changjiang_FNR6045S; LCSC C168076
Logo200, Logo201, Logo202, Logo203: Misc - Logo Increase clockwise; LOGO_CLOCKWISE_INCREASE
Q200, Q203: STR2P3LLH6 - SOT23; SOT23; MANUFACTURER PN STR2P3LLH6
Q201, Q202, Q204, Q205: STT6N3LLH6 - SOT23-6; SOT95P280X145-6N; MANUFACTURER PN STT6N3LLH6
R200, R207, R216: 50 kOhms; POT_3296W; TOLERANCE 10%; MANUFACTURER PN 3296W-1-503RLF
R201, R209: 470Ohm; RES0603; TOLERANCE 1%; MANUFACTURER PN RC0603FR-07470RP
R202, R211: 15KOhm; RES0603; TOLERANCE 1%; MANUFACTURER PN RC0603FR-1015KL
R203, R204, R212, R213: 2Ohm; RES0603; TOLERANCE 1%; MANUFACTURER PN CRCW06032R00FKEA
R205, R214, R215: 1K; RES0603; TOLERANCE 1%; MANUFACTURER PN RC0603FR-071KL
R206: 50 Ohm; RES0603; TOLERANCE 1%; MANUFACTURER PN CRCW060350R0FKEA
R208: 100Ohm; RES0603; TOLERANCE 1%; MANUFACTURER PN CRCW0603100RFKEA
R210: 100 Ohms; POT_3296W; TOLERANCE 10%; MANUFACTURER PN 3296W-1-101LF
R217: 28KOhm; RES0603; TOLERANCE 1%; MANUFACTURER PN AC0603FR-0728KL
R218: 24k; R_0603_1608Metric; LCSC C23352
R219: 2.2k; R_0603_1608Metric; LCSC C4190
R220, R221, R224, R226, R228, R233: 10k; R_0603_1608Metric; LCSC C25804
R222, R231: 4.7k; R_0603_1608Metric; LCSC C23162
R223: 51k; R_0603_1608Metric; LCSC C23196
R225, R227: 200k; R_0603_1608Metric; LCSC C25811
R229: 22k; R_0603_1608Metric; LCSC C31850
R230: 30k; R_0603_1608Metric; LCSC C22984
R232: 2.4k; R_0603_1608Metric; LCSC C22940
R234, R237, R239: 15k; R_0603_1608Metric; LCSC C22809
R235: 12k; R_0603_1608Metric; LCSC C22790
R236, R238: 47k; R_0603_1608Metric; LCSC C25819
R240: 100k; R_0603_1608Metric; LCSC C25803
S200: 30VDC - 4A; SWITCH_25136NAH; MANUFACTURER PN 25136NAH
THP200, THP201, THP202, THP203, THP204, THP205, THP206, THP207, THP208, THP209, THP210: Misc - Test pin - Through hole - Millmax - 6821-0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; MILLMAX_6821-0-00-15-00-00-08-0; MANUFACTURER PN 6821-0-00-15-00-00-08-0
TP200, TP201, TP202, TP203, TP204, TP205, TP206, TP207, TP208, TP209, TP210, TP211: TP; TP_001
U200, U202, U205, U212: TL1963A; SOT223-6; TOLERANCE 70mV; MANUFACTURER PN TL1963ADCQR; LCSC C86720
U201: LDK130_33; SOT95P280X145-5L30; TOLERANCE 3%; MANUFACTURER PN LDK130M33R
U203: ADA4895-1; SOT95P280X145-6N; MANUFACTURER PN ADA4895-1ARJZ-R
U209: CH224A; SSOP-10-1EP_3.9x4.9mm_P1mm_EP2.1x3.3mm; LCSC C42459160
U210: TPS2121RUXR; Texas_VQFN-HR-12_2x2.5mm_P0.5mm; LCSC C485916
U211, U213, U214, U215: TPS62933PDRLR; SOT-583-8; LCSC C5219254

Connections:
1V0: C234.1, C235.1, C236.1, L202.2, R232.1, TP209.1; also elsewhere on the board
1V8: C240.1, C241.1, L203.2, R234.1, TP210.1; also elsewhere on the board
3V3_FPGA: C245.1, C246.1, L204.2, R220.2, R221.2, R236.1, TP211.1; also elsewhere on the board
3V3_OPA: C204.1, C205.1, C207.2, TP204.1, U201.5 (OUT), U203.5 (EN), U203.6 (VS+)
/USBDM: D203.C (K), J200.A7 (D-), J200.B7 (D-); also elsewhere on the board
/USBDP: D204.C (K), J200.A6 (D+), J200.B6 (D+); also elsewhere on the board
/U_DUT_Platform/DUT_GND: CN207.1, R210.1, THP201.1, U203.3 (+); also elsewhere on the board
/U_FPGA/EN_VCC_DUT: Q205.3 (G), R215.2, TP207.1; also elsewhere on the board
/U_FPGA/EN_VCC_PLATFORM: Q202.3 (G), R205.2, TP203.1; also elsewhere on the board
/U_Power/BST_1V0: C233.1, U213.6 (BST)
/U_Power/BST_1V8: C239.1, U214.6 (BST)
/U_Power/BST_3V3_FPGA: C244.1, U215.6 (BST)
/U_Power/BST_VPRE: C227.1, U211.6 (BST)
/U_Power/CC1: J200.A5 (CC1), U209.7 (CC1)
/U_Power/CC2: J200.B5 (CC2), U209.6 (CC2)
/U_Power/DUT_ADJ: R207.2, R207.3, R211.2, U202.5 (ADJ)
/U_Power/DUT_EXT: CN206.1, F203.2
/U_Power/DUT_EXT_IN: CN204.1, F203.1
/U_Power/DUT_LDO_OUT: C209.2, CN206.3, R207.1, THP205.1, TP205.1, U202.4 (OUT)
/U_Power/FB_1V0: R232.2, R233.1, U213.8 (FB)
/U_Power/FB_1V8: R234.2, R235.1, U214.8 (FB)
/U_Power/FB_3V3_FPGA: R236.2, R237.1, U215.8 (FB)
/U_Power/FB_VPRE: R230.2, R231.1, U211.8 (FB)
/U_Power/MUX_ILM: R229.1, U210.10 (ILM)
/U_Power/MUX_OV1: R225.2, R226.1, U210.5 (~OV1)
/U_Power/MUX_OV2: R227.2, R228.1, U210.4 (~OV2)
/U_Power/MUX_PR1: R223.2, R224.1, U210.6 (PR1)
/U_Power/MUX_SS: C223.1, U210.11 (SS)
/U_Power/OPA_INN: R208.2, R214.1, U203.4 (-)
/U_Power/OPA_OUT: R206.1, R214.2, U203.1 (Out)
/U_Power/PD_CFG1: R218.1, U209.9 (CFG1)
/U_Power/PD_LED_A: D208.2 (A), R219.2
/U_Power/PD_PG_N: D208.1 (K), U209.10 (PG)
/U_Power/PG_1V0: U213.7 (PG), U214.2 (EN)
/U_Power/PG_1V8: U214.7 (PG), U215.2 (EN)
/U_Power/PG_3V3: R240.2, U205.1 (EN), U215.7 (PG)
/U_Power/PLAT_ADJ: R200.2, R200.3, R202.2, U200.5 (ADJ)
/U_Power/PLAT_EXT: CN201.1, F202.2
/U_Power/PLAT_EXT_IN: CN200.1, F202.1
/U_Power/PLAT_LDO_OUT: C201.2, CN201.3, R200.1, THP204.1, TP200.1, U200.4 (OUT)
/U_Power/SHUNT_OUT: CN205.1, R206.2, THP200.1
/U_Power/SW_1V0: C233.2, L202.1, U213.5 (SW)
/U_Power/SW_1V8: C239.2, L203.1, U214.5 (SW)
/U_Power/SW_3V3_FPGA: C244.2, L204.1, U215.5 (SW)
/U_Power/SW_VPRE: C227.2, L201.1, U211.5 (SW)
/U_Power/VCCIO_ADJ: R216.2, R216.3, R217.2, U205.5 (ADJ)
/U_Power/VCC_DUT_DISCH_GATE: D206.1 (A), Q204.3 (G), R213.2
/U_Power/VCC_DUT_GATE: D205.2 (K), Q203.1 (G), R212.2
/U_Power/VCC_DUT_GATE_DRV: D205.1 (A), D206.2 (K), Q205.1 (D), Q205.2 (D), Q205.5 (D), Q205.6 (D), R209.1, R212.1, R213.1
/U_Power/VCC_PLATFORM_DISCH_GATE: D201.1 (A), Q201.3 (G), R204.2
/U_Power/VCC_PLATFORM_GATE: D200.2 (K), Q200.1 (G), R203.2
/U_Power/VCC_PLATFORM_GATE_DRV: D200.1 (A), D201.2 (K), Q202.1 (D), Q202.2 (D), Q202.5 (D), Q202.6 (D), R201.1, R203.1, R204.1
/U_Power/VSUP_ADJ: R238.2, R239.1, U212.5 (ADJ)
GND: C200.1, C201.1, C202.1, C204.2, C205.2, C206.1, C207.1, C208.1, C209.1, C210.1, C217.1, C218.1, C221.2, C222.2, C223.2, C224.2, C225.2, C226.2, C228.2, C229.2, C230.2, C231.2, C232.2, C234.2, C235.2, C236.2, C237.2, C238.2, C240.2, C241.2, C242.2, C243.2, C245.2, C246.2, C247.2, C248.2, CN200.2, CN202.2, CN204.2, CN205.2, CN205.3, CN207.2, D203.A, D204.A, D207.2 (A), D209.2 (A), D210.2 (A), J200.A1 (GND), J200.A12 (GND), J200.B1 (GND), J200.B12 (GND), J200.SH (SHIELD), Q201.4 (S), Q202.4 (S), Q204.4 (S), Q205.4 (S), R202.1, R205.1, R208.1, R210.2, R210.3, R211.1, R215.1, R217.1, R218.2, R224.2, R226.2, R228.2, R229.2, R231.2, R233.2, R235.2, R237.2, R239.2, THP202.1, THP206.1, THP207.1, THP208.1, THP209.1, THP210.1, U200.3 (GND), U200.6 (GND), U201.2 (GND), U202.3 (GND), U202.6 (GND), U203.2 (GND), U205.3 (GND), U205.6 (GND), U209.11 (GND), U210.3 (CP2), U210.9 (ST), U210.12 (GND), U211.4 (GND), U212.3 (GND), U212.6 (GND), U213.4 (GND), U214.4 (GND), U215.4 (GND); also elsewhere on the board
PD_SCL: R220.1, U209.2 (CFG2/SCL); also elsewhere on the board
PD_SDA: R221.1, U209.3 (CFG3/SDA); also elsewhere on the board
VBUS_C: C221.1, D207.1 (K), J200.A4 (VBUS), J200.A9 (VBUS), J200.B4 (VBUS), J200.B9 (VBUS), R219.1, R222.1, R227.1, U209.1 (VHV), U209.8 (VBUS), U210.2 (IN2)
VBUS_SENSE: D209.1 (K), R222.2; also elsewhere on the board
VCC_DUT: Q203.3 (D), Q204.1 (D), Q204.2 (D), Q204.5 (D), Q204.6 (D), TP206.1; also elsewhere on the board
VCC_DUT_PERMANENT: C210.2, CN206.2, Q203.2 (S), R209.2; also elsewhere on the board
VCC_IO_FPGA: C218.2, R216.1, THP203.1, U205.4 (OUT); also elsewhere on the board
VCC_PLATFORM: Q200.3 (D), Q201.1 (D), Q201.2 (D), Q201.5 (D), Q201.6 (D), TP201.1; also elsewhere on the board
VCC_PLATFORM_PERMANENT: C202.2, CN201.2, Q200.2 (S), R201.2; also elsewhere on the board
VEXT: C222.1, CN202.1, D210.1 (K), R223.1, R225.1, U210.7 (IN1)
VIN: C225.1, C226.1, C231.1, C232.1, C237.1, C238.1, C242.1, C243.1, S200.2, TP202.1, U211.3 (VIN), U213.3 (VIN), U214.3 (VIN), U215.3 (VIN)
VIN_MUX: C224.1, S200.3, U210.1 (OUT), U210.8 (OUT)
VPRE: C200.2, C208.2, C217.2, C228.1, C229.1, C230.1, C247.1, L201.2, R230.1, TP208.1, U200.1 (EN), U200.2 (IN), U202.1 (EN), U202.2 (IN), U205.2 (IN), U212.1 (EN), U212.2 (IN)
Vsupply: C206.2, C248.1, R238.1, R240.1, U201.1 (IN), U201.3 (EN), U212.4 (OUT); also elsewhere on the board

Notes on the sheet:
USB-C input, USB-PD sink (requests 12 V). CH224A DP/DM must stay unconnected.
External input 7-20 V (priority over USB-C above 6.5 V), input mux, power switch
VPRE buck: U211
1V0 buck: U213
1V8 buck: U214
3V3_FPGA buck: U215
Rail test points
Vsupply 5.0 V (FT232RL, level shifters, 5 V pulse outputs)
VCC_IO_FPGA 1.21-3.37 V (banks 34/35), enabled after 3V3_FPGA is good
Platform supply 1.21 V-5.2 V, 1.5 A
DUT supply 1.21 V-5.2 V, 1.5 A
Current measurement (gain 11, 50 ohm output)
