KarpelesLab/scaffold/hw/kicad/Scaffold.kicad_pcb

## KiCad design hw/kicad/Scaffold.kicad_pcb (continued)

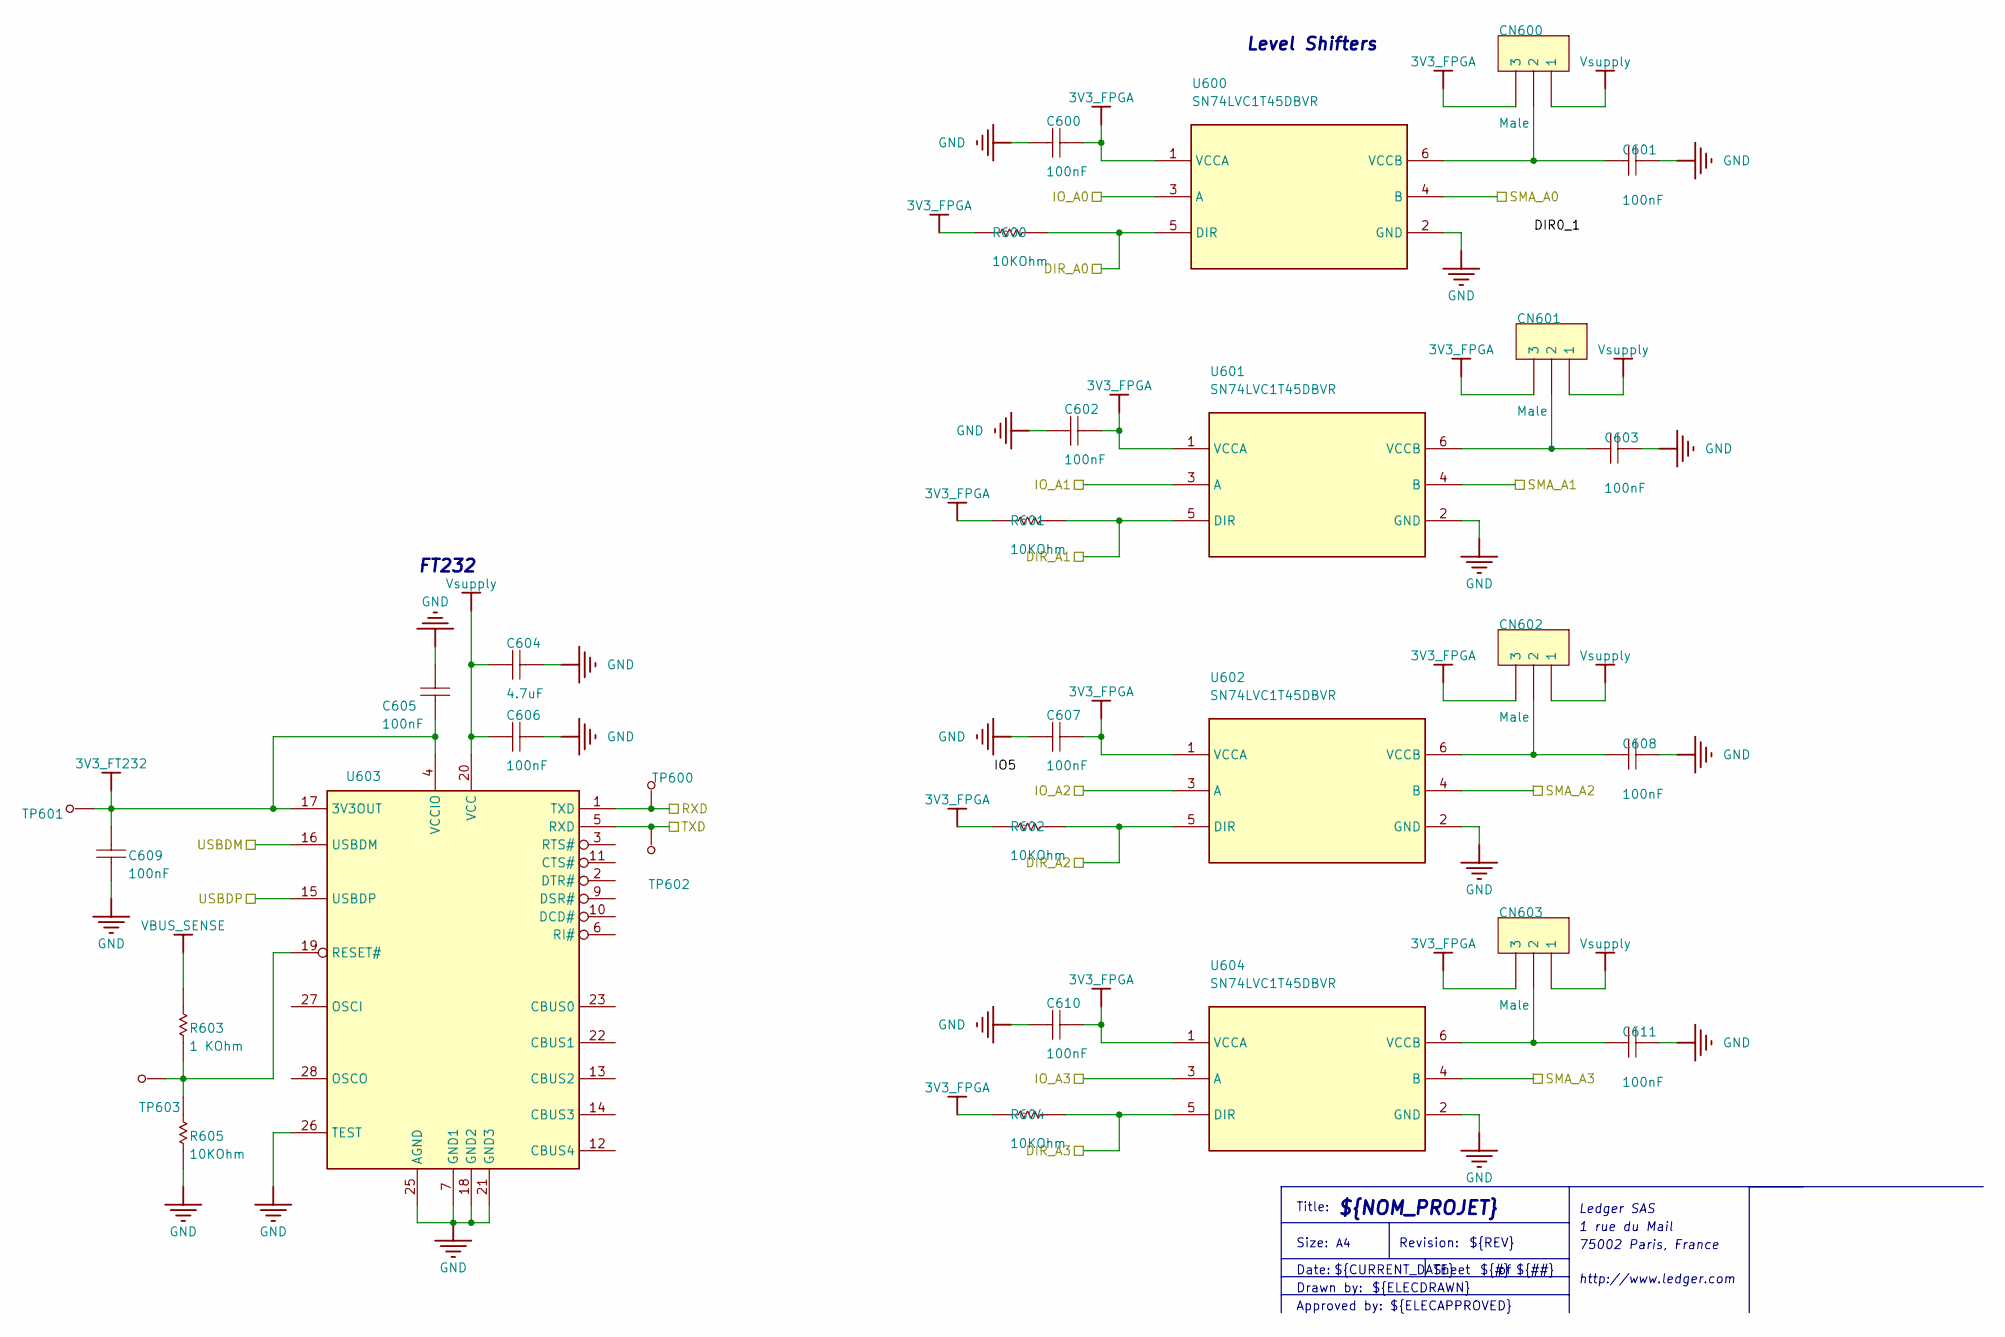
[picture p9: schematic RS232_Level_Shifters.kicad_sch]

Parts:
C600, C601, C602, C603, C605, C607, C608, C609, C610, C611: 100nF; CAP0603; TOLERANCE 10%; MANUFACTURER2 PN MCCA000159
C604: 4.7uF; CAP0603; TOLERANCE 10%; MANUFACTURER PN GRM188R61C475KE11
C606: 100nF; CAP0603; TOLERANCE 10%; MANUFACTURER PN 885012206046
CN600, CN601, CN602, CN603: Male; MOLEX_90120-0123; MANUFACTURER PN 90120-0123
R600, R601, R602, R604, R605: 10KOhm; RES0603; TOLERANCE 1%; MANUFACTURER PN RC0603FR-0710KL
R603: 1 KOhm; RES0603; TOLERANCE 1%; MANUFACTURER PN 0603WAF1001T5E
TP600, TP601, TP602, TP603: TP; TP_001
U600, U601, U602, U604: SN74LVC1T45DBVR; SOT95P280X145-6N; MANUFACTURER PN SN74LVC1T45DBVR
U603: IC - USB-to-UART 1-CH 256Byte FIFO - 5V - 28-Pin 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; SSOP28DB; MANUFACTURER PN FT232RL

Connections:
3V3_FPGA: C600.2, C602.2, C607.2, C610.2, CN600.3, CN601.3, CN602.3, CN603.3, R600.2, R601.2, R602.2, R604.2, U600.1 (VCCA), U601.1 (VCCA), U602.1 (VCCA), U604.1 (VCCA); also elsewhere on the board
3V3_FT232: C605.1, C609.1, TP601.1, U603.4 (VCCIO), U603.17 (3V3OUT)
/USBDM: U603.16 (USBDM); also elsewhere on the board
/USBDP: U603.15 (USBDP); also elsewhere on the board
/U_Connectors/IO_SMA0: U600.4 (B); also elsewhere on the board
/U_Connectors/IO_SMA1: U601.4 (B); also elsewhere on the board
/U_Connectors/IO_SMA2: U602.4 (B); also elsewhere on the board
/U_Connectors/IO_SMA3: U604.4 (B); also elsewhere on the board
/U_FPGA/DIR_A0: R600.1, U600.5 (DIR); also elsewhere on the board
/U_FPGA/DIR_A1: R601.1, U601.5 (DIR); also elsewhere on the board
/U_FPGA/DIR_A2: R602.1, U602.5 (DIR); also elsewhere on the board
/U_FPGA/DIR_A3: R604.1, U604.5 (DIR); also elsewhere on the board
/U_FPGA/IO_A0: U600.3 (A); also elsewhere on the board
/U_FPGA/IO_A1: U601.3 (A); also elsewhere on the board
/U_FPGA/IO_A2: U602.3 (A); also elsewhere on the board
/U_FPGA/IO_A3: U604.3 (A); also elsewhere on the board
/U_FPGA/RXD: TP600.1, U603.1 (TXD); also elsewhere on the board
/U_FPGA/TXD: TP602.1, U603.5 (RXD); also elsewhere on the board
GND: C600.1, C601.1, C602.1, C603.1, C604.2, C605.2, C606.2, C607.1, C608.1, C609.2, C610.1, C611.1, R605.1, U600.2 (GND), U601.2 (GND), U602.2 (GND), U603.7 (GND1), U603.18 (GND2), U603.21 (GND3), U603.25 (AGND), U603.26 (TEST), U604.2 (GND); also elsewhere on the board
unnamed: C601.2, CN600.2, U600.6 (VCCB)
unnamed: C603.2, CN601.2, U601.6 (VCCB)
unnamed: C608.2, CN602.2, U602.6 (VCCB)
unnamed: R603.1, R605.2, TP603.1, U603.19 (RESET#)
unnamed: C611.2, CN603.2, U604.6 (VCCB)
VBUS_SENSE: R603.2; also elsewhere on the board
Vsupply: C604.1, C606.1, CN600.1, CN601.1, CN602.1, CN603.1, U603.20 (VCC); also elsewhere on the board

Notes on the sheet:
Sheet
Title:
Approved by:
Drawn by:
Revision:
Date:
${CURRENT_DATE}
${#}
Ledger SAS
${REV}
Size:
${NOM_PROJET}
75002 Paris, France
${ELECAPPROVED}
FT232
${##}
http://www.ledger.com
1 rue du Mail
Level Shifters
${ELECDRAWN}

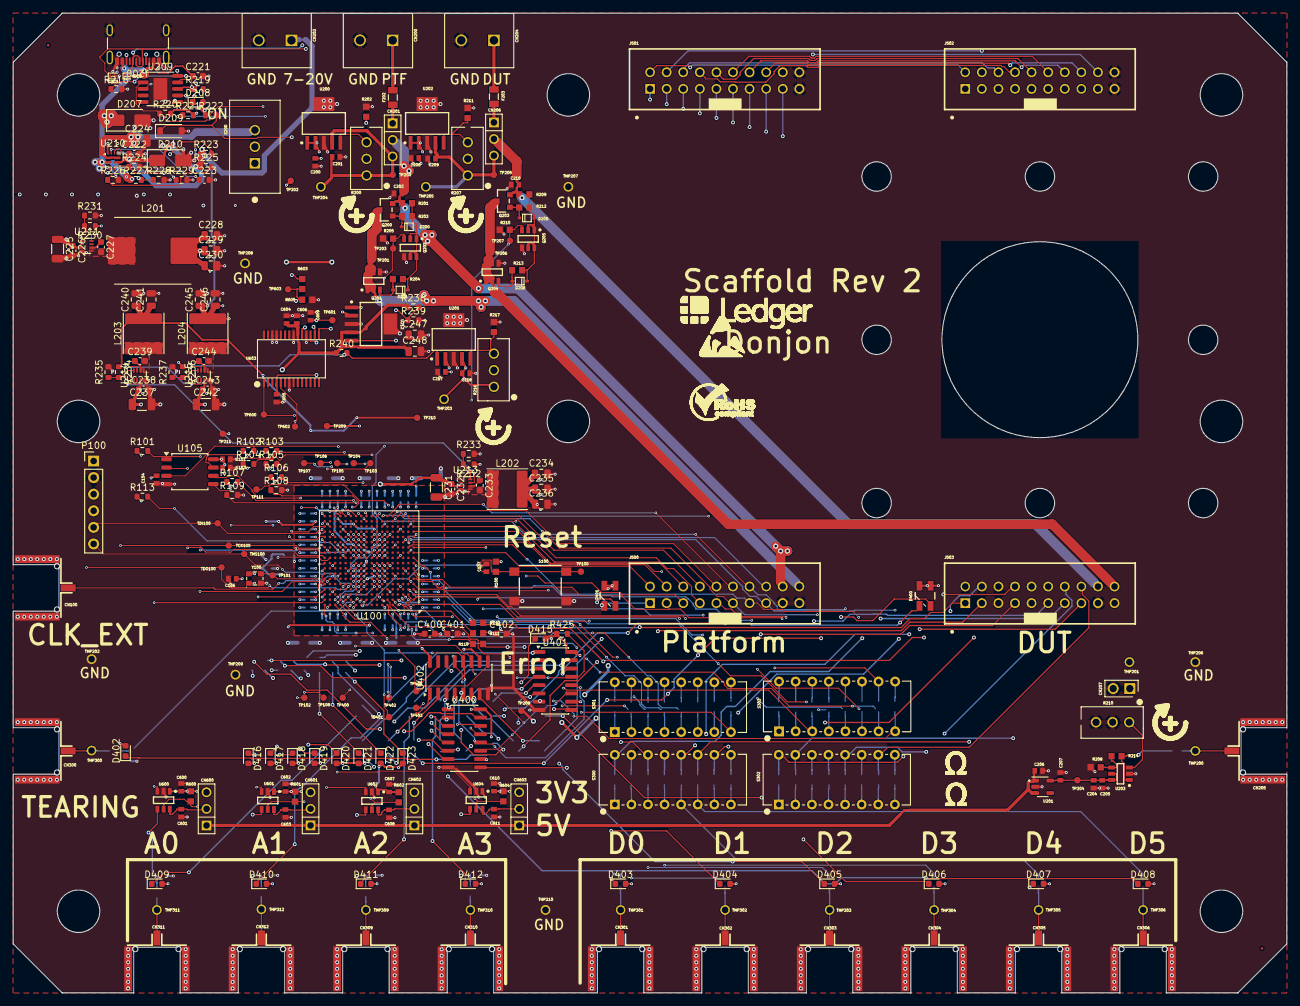
[picture p10: board Scaffold.kicad_pcb from above]

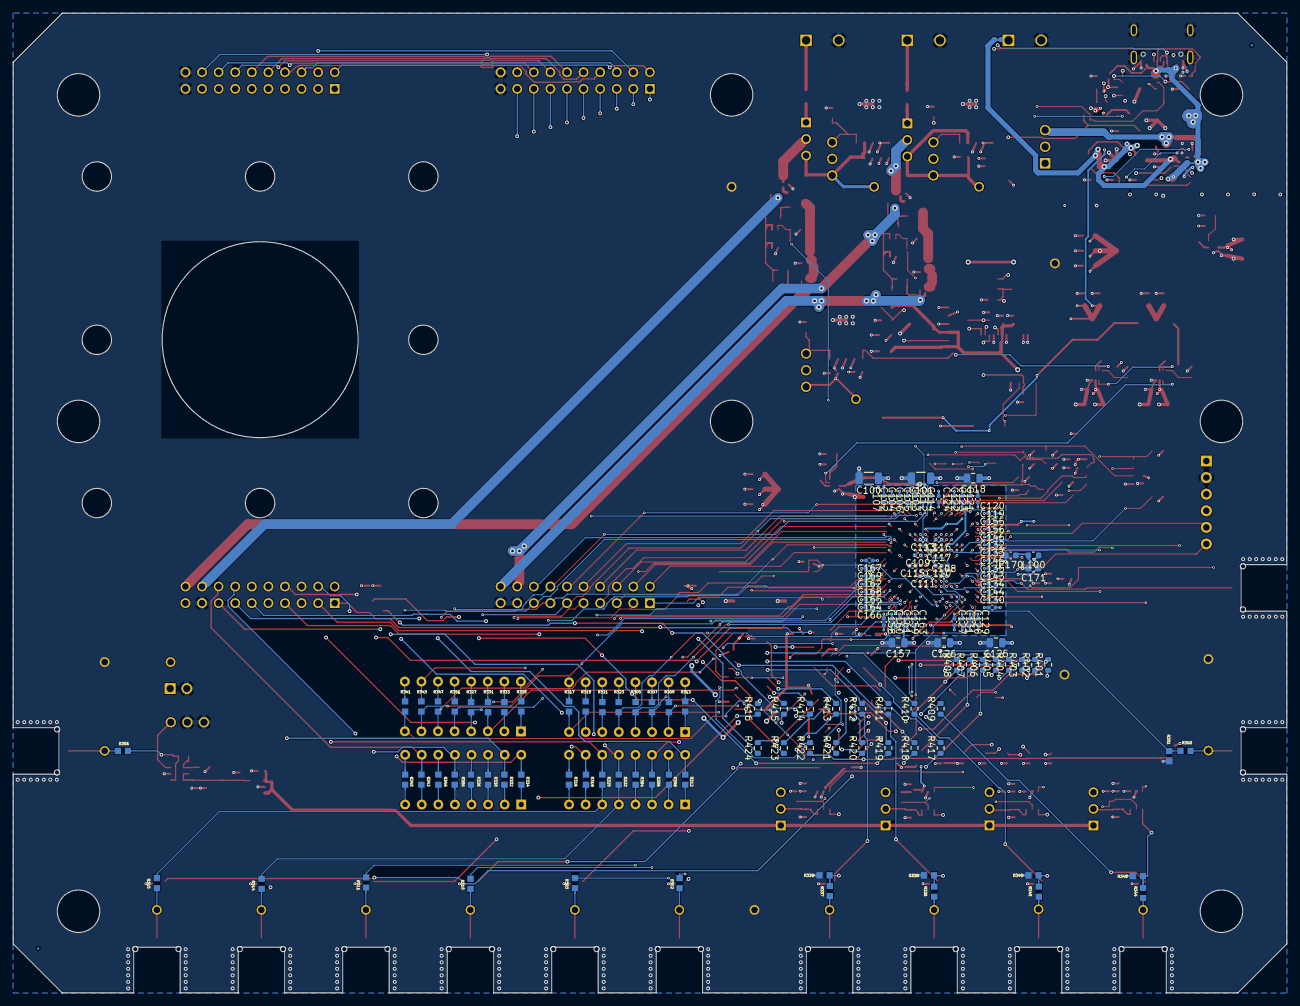
[picture p11: board Scaffold.kicad_pcb from below]

Board: 6 copper layers, 195.0 x 150.0 mm, 422 parts (133 on the bottom side), 252 nets.

Other parts of the board:
Logo1: Logo Ledger; logo_Ledger_new - Horizontale
Logo2: Logo ESD; LOGO ESD
Logo3: Logo ROHS
M1, M2, M3, M4: Mire; MIRE
