KarpelesLab/scaffold/(commit log)

2026-11-07 Rev 2 groundwork: Artix-7 gateware port and hardware design spec
    - fpga-arch/artix7: vendor-neutral fifo512 and down counters, MMCM-based
    pll, Vivado non-project build script and constraints skeleton (pin
    assignment pending PCB). The Rev 1.x Quartus project is unchanged.
    - fpga-sim/artix7: self-checking nvc testbench for the portable modules.
    - hw/rev2/DESIGN.md: USB-C/PD power tree, FPGA and part selection (LCSC
    codes) for the Rev 2 board.
    - hw/rev2/jlc_check.py: JLCPCB stock checker.
2026-11-07 Rev 2: replace TLC5952 LED driver with 74HC595 chain, choose 6 layers
    The TLC5952 is not stocked by JLCPCB. The Artix-7 build gets a
    tlc5952_driver with the same ports driving three daisy-chained 74HC595,
    with brightness as PWM on /OE, and a self-checking testbench.
    DESIGN.md records the 6-layer stackup and the LED driver wiring.
    [tb_leds.vhd, tlc5952_driver.vhd]
2026-11-07 Import Rev 1.1 Altium project into KiCad 10 (hw/kicad)
    Unmodified output of KiCad's Altium importer (File > Import Non-KiCad
    Project), as a baseline for the Rev 2 changes. Checked: the schematic
    netlist matches the PCB connectivity on all 991 common pins. Known import
    leftovers, fixed in follow-up commits: SMA connector pad names (S1/G1/G2 vs
    symbol pins 1/2/3), missing SOD323/A footprint, annotation errors, and two
    images from the original author's machine (LDO chart, potentiometer
    direction icon) that were not embedded in the Altium files.
    [Connectors.kicad_sch, DUT_Platform.kicad_sch, FPGA.kicad_sch, LEDs.kicad_sch, Power.kicad_sch, RS232_Level_Shifters.kicad_sch, Scaffold.kicad_pcb, Scaffold.kicad_sch]
2026-11-07 KiCad import: fix SMA pad numbers, SOD323 footprint name, power symbol annotation
    - SAMTEC SMA footprint pads S1/G1/G2 renamed to 1/2/3 to match the
    symbol pins (Altium mapped them, KiCad matches by number).
    - SOD323/A footprint was imported as 'A' (slash in the name); renamed to
    SOD323_A in the library, the PCB and the BAT60J symbols.
    - 224 unannotated power symbols (#PWR?) numbered.
    Schematic netlist and PCB now agree on all 1030 pins, and the PCB has no
    unconnected items.
    [Connectors.kicad_sch, DUT_Platform.kicad_sch, FPGA.kicad_sch, LEDs.kicad_sch, Power.kicad_sch, RS232_Level_Shifters.kicad_sch, Scaffold.kicad_pcb]
2026-11-07 Rev 2 schematic: USB-C, USB-PD and new power tree (Power sheet)
    The Power sheet is regenerated from data by hw/rev2/tools/gen_power.py
    (label-connected, on top of a small KiCad sheet generator, kisch.py):
    - USB-C receptacle (GCT USB4105-GF-A) with CH224A PD sink requesting 12 V,
    PD status LED, I2C to the FPGA; DP/DM of the CH224A left unconnected.
    - External 7-20 V input with priority, OV and current limit through a
    TPS2121 power mux, SMAJ20A TVS on both inputs.
    - Four TPS62933P bucks: VPRE 5.9 V for the low-noise LDOs, and 1V0, 1V8,
    3V3 for the Artix-7 with PG-chained sequencing; VCC_IO_FPGA LDO enabled
    last.
    - Platform/DUT supplies and current measurement carried over unchanged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
    [Power.kicad_sch, RS232_Level_Shifters.kicad_sch]
2026-11-07 Rev 2 schematic: 74HC595 LED driver (LEDs sheet)
    The LEDs sheet is regenerated by hw/rev2/tools/gen_leds.py: three
    daisy-chained 74HC595 on 3V3_FPGA replace the TLC5952 (not stocked by
    JLCPCB). LED anodes move to 3V3_FPGA, cathodes sink through 680/330 ohm
    resistors into the 595 outputs; every LED keeps its Rev 1.1 channel.
    LED_/OE has a pull-up so the LEDs stay off until the FPGA is configured.
    The Artix-7 LED driver now shifts the inverted bits (active-low outputs);
    the testbench models the inversion and passes.
    verify.py: no connectivity change outside the Power and LEDs sheets, all
    LED interface signals still reach the FPGA, no dangling net; ERC clean on
    the LEDs sheet.
    Co-Authored-By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
    [LEDs.kicad_sch]
2026-11-07 Rev 2 schematic: Artix-7 XC7A35T/XC7A100T in CSG324 (FPGA sheet)
    The FPGA sheet is regenerated by hw/rev2/tools/gen_fpga.py:
    - XC7A35T-1CSG324I (XC7A100T on the same footprint), banks 34/35 on the
    adjustable VCC_IO_FPGA for the DUT/platform I/Os, banks 0/14/15/16 on
    3V3_FPGA.
    - Master SPI x4 configuration from a W25Q128JVSIQ, mode straps, PUDC_B high,
    Digilent-compatible 6-pin JTAG header.
    - Decoupling per UG483 Table 2-2 sized for the XC7A100T.
    - Oscillator, external clock SMA, reset button, D0-D2 pull resistors and
    test points carried over from Rev 1.1.
    - Automatic pin assignment written to hw/rev2/fpga_pins.csv; the Vivado
    pin constraints are generated from it (gen_xdc.py).
    The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
    [FPGA.kicad_sch, LEDs.kicad_sch, Power.kicad_sch, fpga_pins.csv]
2026-11-07 Rev 2 PCB: sync board with the new schematic (layout in progress)
    hw/rev2/tools/update_pcb.py does what KiCad's 'Update PCB from
    Schematic' does, through the pcbnew API:
    - every footprint is now linked to its schematic symbol (the Altium import
    had unrelated paths), so GUI updates work from here on;
    - 55 parts replaced in place (new FPGA, flash, USB-C, LED registers,
    decoupling...), 114 new parts staged to the right of the board,
    24 removed parts deleted; mounting holes, DUT socket opening and
    fiducials kept;
    - pad nets set from the netlist: 1438 pins checked, no mismatch;
    - all Rev 1.1 copper removed (the Altium import produced ~1500 zones and
    the routing served the old FPGA), boa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
    [FPGA.kicad_sch, Scaffold.kicad_pcb]
2026-11-07 Rev 2: JLCPCB output pipeline, LCSC mapping, 0603 LEDs
    - hw/rev2/make_jlc.py produces the JLCPCB files from the KiCad board:
    6-layer Gerbers + Excellon (PTH/NPTH) zipped, BOM (Comment, Designator,
    Footprint, LCSC), CPL (part centres from pads, absolute coordinates
    matching the Gerbers), hand-assembly list, DRC and summary report.
    - hw/rev2/lcsc_map.csv maps the Rev 1.1 manufacturer part numbers to LCSC
    codes (JLC basic equivalents for generic passives) and lists the parts
    JLCPCB does not stock (Samtec SMA and HTSS headers, terminal blocks,
    switches, test pins): those go to the hand-assembly list.
    - Kingbright AA3528 LEDs (out of stock at JLCPCB) replaced by 0603 LEDs.
    - Silkscree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
    [LEDs.kicad_sch, Scaffold.kicad_pcb, lcsc_map.csv]
2026-11-07 Rev 2 PCB: placement, BGA fanout, decoupling and planes
    - place.py: all new/replaced parts placed by function (USB-C at the old
    micro-USB spot facing the edge, PD/mux below it, bucks in the former logo
    area, 1V0 buck next to the BGA, BGA in place of the TQFP rotated 180
    degrees so banks 34/35 face the DUT/platform headers, LED registers and
    resistors near the LEDs). No courtyard overlap.
    - fanout.py: dog-bone fanout of the CSG324 (120 vias), 49 0402
    decoupling capacitors (8 on supply/GND via pairs under the BGA, 41 in a
    ring matched to the plane regions), bulk capacitors, ground planes on
    In1/In4, In3 split into 1V0 (core + corridor to its buck), 1V8, 3V3
    (left), VCC_IO (righ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
    [FPGA.kicad_sch, Scaffold.kicad_pcb]
2026-11-07 Rev 2 PCB: fix placement obstacles and via collisions, layout pipeline
    - place.py: mounting holes (all with an empty reference) were collapsed in
    the reference dict and ignored as obstacles; JTAG header P100 overlapped
    one. Obstacles now come from every footprint, holes from their pads.
    Rev 1.1 silkscreen labels updated (5V-SEL removed, 7-20V input, JTAG).
    - fanout.py: vias added outside the BGA (decoupling ring, bulk caps) are
    checked against the pads of both sides and other vias (a bulk cap GND
    via landed on the 1V0 inductor pad).
    - layout.sh: schematic -> rules -> PCB sync -> placement -> fanout,
    stopping at the first error. make_jlc.py refills zones before export.
    DRC: no cl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
    [Scaffold.kicad_pcb]
2026-11-08 Rev 2 PCB: plane stitching and switch-node copper before autorouting
    The first Freerouting run (78 min) left 328 of 802 connections unrouted,
    almost all ground/plane connections (Freerouting is poor at dropping
    hundreds of plane vias) and power tracks too wide for fine-pitch pads.
    - stitch.py: a short track and via to its plane for every SMD pad of
    GND and of the In3 rails over their region (189 vias), collision-checked
    on both sides; top-layer copper zones for the four buck switch nodes.
    - Power classes narrowed for the remaining routed power links (POWER
    0.5 mm, FPGA_PWR 0.3 mm).
    - route.py: Freerouting export/import (planes as power layers, fanout
    locked, outer pours removed duri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
    [Scaffold.kicad_pcb]
2026-11-08 Rev 2 PCB: autorouted (pass 2), post-route fixes, incremental stitching
    - Freerouting pass 2 imported (route.py drops the SES placement section,
    which lists the mounting holes under unmatched placeholder references and
    made KiCad reject the whole session).
    - postroute.py: widens the 0.06-0.075 mm pad-entry segments Freerouting
    emits to 0.1 mm, deletes the few slivers that then come too close to
    another net, solid zone connection for the GND test pins.
    - 3V3 power plane extended below the BGA up to x = 140 mm (LED registers,
    level shifters); stitching can run incrementally; POWER class 0.4 mm.
    State: 84 unconnected pads left (mostly 3V3/power links), no clearance,
    short or width er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
    [Scaffold.kicad_pcb]
2026-11-08 Rev 2 PCB: buck regulator layout template, VIN/VPRE/3V3 plane regions
    The generic region packer had spread each TPS62933P's parts over its
    region (bootstrap caps 9-19 mm from the regulator, box-shaped switch-node
    zones split into islands). buck.py places every buck from a fixed template:
    input caps at VIN/GND, bootstrap cap at BST/SW, inductor next to SW,
    output caps against the inductor, FB divider above the IC, and draws the
    input-loop, bootstrap, output tracks and a switch-node zone that only
    spans pin 5, the Cbst SW pad and the inductor SW pad.
    Planes: VIN zone on In2 under the buck inputs (tied to the In3 VIN
    region), VPRE extended to the LDO inputs, 3V3 over the LED rows (no
    VCC_IO lo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
    [Scaffold.kicad_pcb]
2026-11-08 Rev 2: DSN export turns signal-layer planes into keepouts; document layout flow
    Freerouting fails to parse a plane on a signal layer (the In2 VIN zone):
    export it as a wire keepout instead. DESIGN.md: buck template, plane
    regions, incremental routing flow, make_jlc.py outputs.
2026-11-08 Rev 2 PCB: routing pass 4 (100 -> 66 unconnected)
    [Scaffold.kicad_pcb]
2026-11-08 Rev 2 PCB: scripted J501-J502 bus, buck FB tracks and EN/PG escapes (52 unconnected)
    The odd pins of J501 and J502 form a shifted parallel bus: every pair of
    nets interleaves, so no single-layer route exists and Freerouting never
    attempted them. manual_routes.py routes them on B.Cu stubs plus stepped
    In2 runs. buck.py now also draws the feedback divider and gives EN/PG an
    escape via to the bottom layer (top layer full, In2 kept for VIN there).
    Pruned 432 dangling stubs left by pass 4.
    [Scaffold.kicad_pcb]
2026-11-08 Rev 2 PCB: routing pass 5 (52 -> 43 unconnected)
    [Scaffold.kicad_pcb]
2026-11-08 Rev 2 PCB: grid maze router for the connections Freerouting leaves (43 -> 9 unconnected)
    maze_export.py (KiCad) -> maze.py (numpy/scipy A* over top, In2 and
    bottom, net-class clearances, plane-aware connectivity) -> maze_apply.py
    (group rev2_maze, locked by route.py). ripup.py clears routed copper in a
    box when a pad is boxed in. Remaining: VBUS_C and MUX_OV1 at U210
    (boxed in), DUT_D2 at R112, a 1V8 plane island, and one PG_1V0
    clearance miss (0.193 vs 0.2 mm) that the corrected margins now prevent.
    [Scaffold.kicad_pcb]
2026-11-08 Rev 2 PCB: USB-C input connected, mux area re-routed, 1V8 plane joined (6 unconnected)
    - U210 (TPS2121): VBUS_C input pin was boxed in and never connected. C224
    moved above-right of U210 (its outputs are above its inputs, a cap below
    forced a crossing); mux area re-routed in a working order.
    - 1V8/1V0 Power-layer zones at 0.1 mm clearance (net-class rule): at
    0.15 mm the interleaved ground vias cut the 1V8 strip in three.
    - maze.py: item-overlap connectivity (raster adjacency merged gaps), exact
    pad growth with sound grid margins, neck width near own pads, per-net
    width/via override, NET@REF[.PIN] filter, MAZE_TIGHT for fine pitch.
    - maze_export.py: one item per zone fragment, inne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
    [Scaffold.kicad_pcb]
2026-11-08 Rev 2 PCB: LED resistors spread, LED area re-routed shortest-first, TVS ground vias (5 unconnected)
    - R409-R424 in two rows at 4 mm pitch (were 2 mm: no room for both ends).
    - stitch.py: skip only the SAMTEC SMA connectors (the 'SMA' match also
    skipped the DO-214AC TVS diodes D207/D210: no ground via); three vias on
    large plane-net pads.
    - maze.py: MAZE_SHORT_FIRST ordering.
    [Scaffold.kicad_pcb]
2026-11-08 Rev 2 PCB: fully routed (0 unconnected, no clearance/short errors)
    Last nets: LED_LE (FPGA ball A14 boxed in) and LED12_K, after a local
    rip-up, routed first.
    [Scaffold.kicad_pcb]
2026-11-08 Rev 2 PCB: 3 A input stage widened (VBUS_C, VEXT, VIN_MUX 0.8 mm outer, multiple vias)
    The override parsing kept only the last setting per net, so the VBUS_C
    main path had been routed 0.25 mm with a 0.45 mm via. Overrides are now
    per argument; new maze.py flags: ^ (outer 1 oz layers only), + (up to two
    extra vias at each layer change), ! (no vias), neck width per net.
    ripup.py --nets rips up whole nets. D207 (VBUS TVS) joined at 0.8 mm,
    second USB-C VBUS pin pair at 0.5 mm.
    [Scaffold.kicad_pcb]
2026-11-08 Rev 2 PCB: DUT/platform supplies 1.5 mm on outer layers with multiple vias
    VCC_DUT/VCC_PLATFORM (and their pre-switch PERMANENT nets) carry up to
    1.5 A over ~120 mm to J500/J503: they were 0.4 mm, partly on the 0.5 oz
    inner layer (~0.29 ohm, 0.44 V drop at 1.5 A). Now 1.5 mm, 1 oz outer
    layers (~0.04 ohm).
    [Scaffold.kicad_pcb]
2026-11-08 Rev 2: JLCPCB outputs for the routed board; outline and test point clean-up
    - hw/rev2/jlc: Gerbers + drill (zip), BOM, CPL, hand-assembly list, DRC
    report. 326 parts by JLCPCB, 50 by hand; all BOM lines in stock for 5
    boards. DRC: 0 unconnected, 95 errors all in legacy footprints (edge
    SMA connectors, USB4105 land pattern).
    - Gerber prefix scaffold-rev2 (was a hidden .jlc-export name).
    - 74 zero-length Edge.Cuts segments from the Altium import removed;
    35 test points with an unresolved ${ALTIUM_VALUE} value set to TP.
    - DESIGN.md: routing flow as done, accepted DRC items, placement changes,
    pre-order checklist (layout review, order options, stock).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
    [FPGA.kicad_sch, LEDs.kicad_sch, Power.kicad_sch, RS232_Level_Shifters.kicad_sch, Scaffold.kicad_pcb, bom-jlc.csv, hand-assembly.csv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]
2026-11-09 Rev 2 PCB: layout review with openEMS and DC drop analysis
    - hw/rev2/sim: copper export, DC drop/current density solver, openEMS
    FDTD model of board regions (GPU engine), test cases and results
    - SMA connectors: 7 ground vias in each ground leg (none before)
    - TL1963A tabs: thermal via grids (U200, U202, U205)
    - VBUS_C/VEXT/VIN_MUX widened where they clear, parallel VEXT links
    at the TPS2121 (VEXT drop at 4 A 151 -> 123 mV)
    - Board stackup set to JLC06161H-2116 (was the 4-layer Altium one)
    - JLC outputs regenerated (DRC: same 95 legacy-footprint errors,
    0 unconnected)
    [Scaffold.kicad_pcb]
